paperdink/paperd.ink_hw/rev2/Output/DXF/paperd.ink.dxf

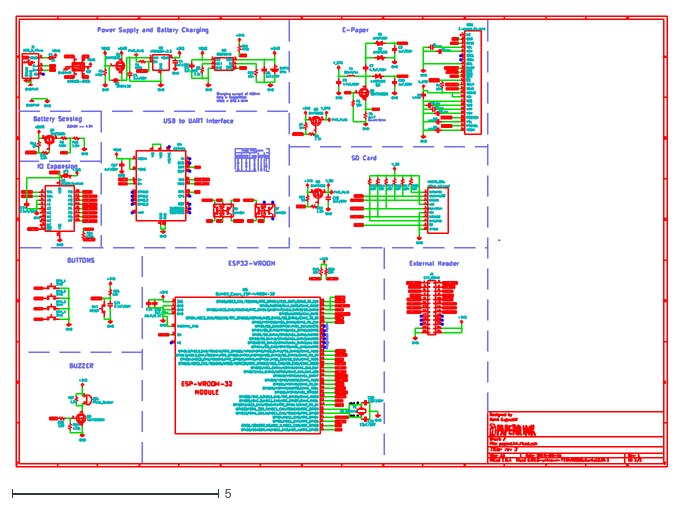
[picture p1: CAD file, 2022-04-13, an earlier design]
rev2/Output/DXF/paperd.ink.dxf
15.7 x 10.9
