paperdink/paperd.ink_hw/(list of files, cad)

Other CAD files:
rev1/Output/DXF/paperd.ink_main_pcb-B_SilkS.dxf
rev1/Output/DXF/paperd.ink_main_pcb-F_SilkS.dxf
