paperdink/paperd.ink_hw/rev4/Output/paperd_ink_rev4.pdf

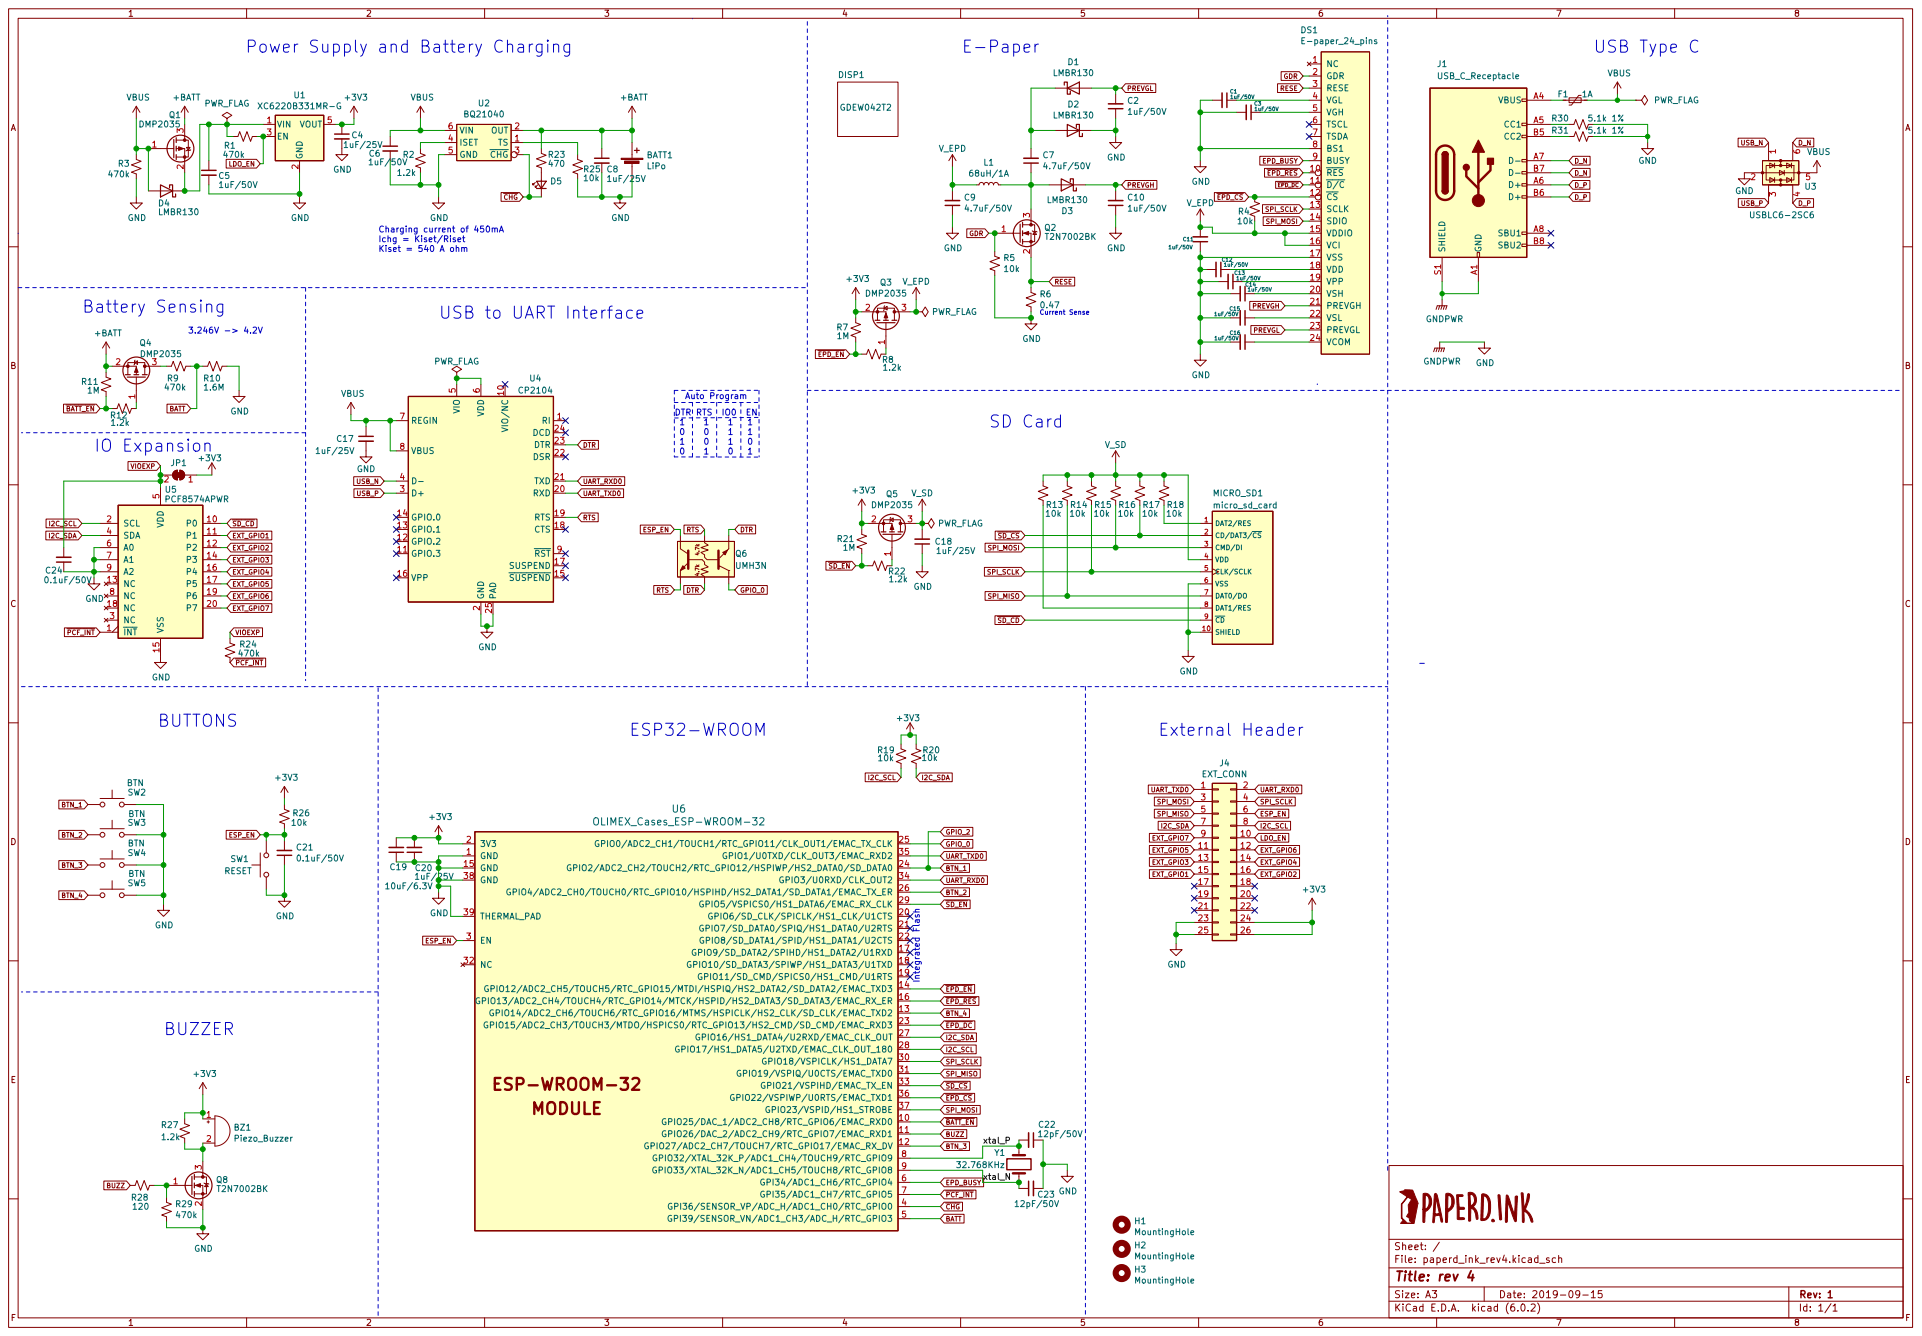
[picture p2: page 1]

Current Sense E-Paper Integrated Flash

- Power Supply and Battery Charging

0 1 0 1 Charging current of 450mA
Ichg = Kiset/Riset Kiset = 540 A ohm

USB to UART Interface

6 REGIN 7 VBUS 8 ~{RST} 9 U4 CP2104 GND

2 RXD 20 TXD 21 DSR 22 DTR 23 DCD 24 PAD 25 D+ 3 D- 4 VIO
