paperdink/paperd.ink_hw/rev1/Output/PDF/paperd.ink_V1.pdf

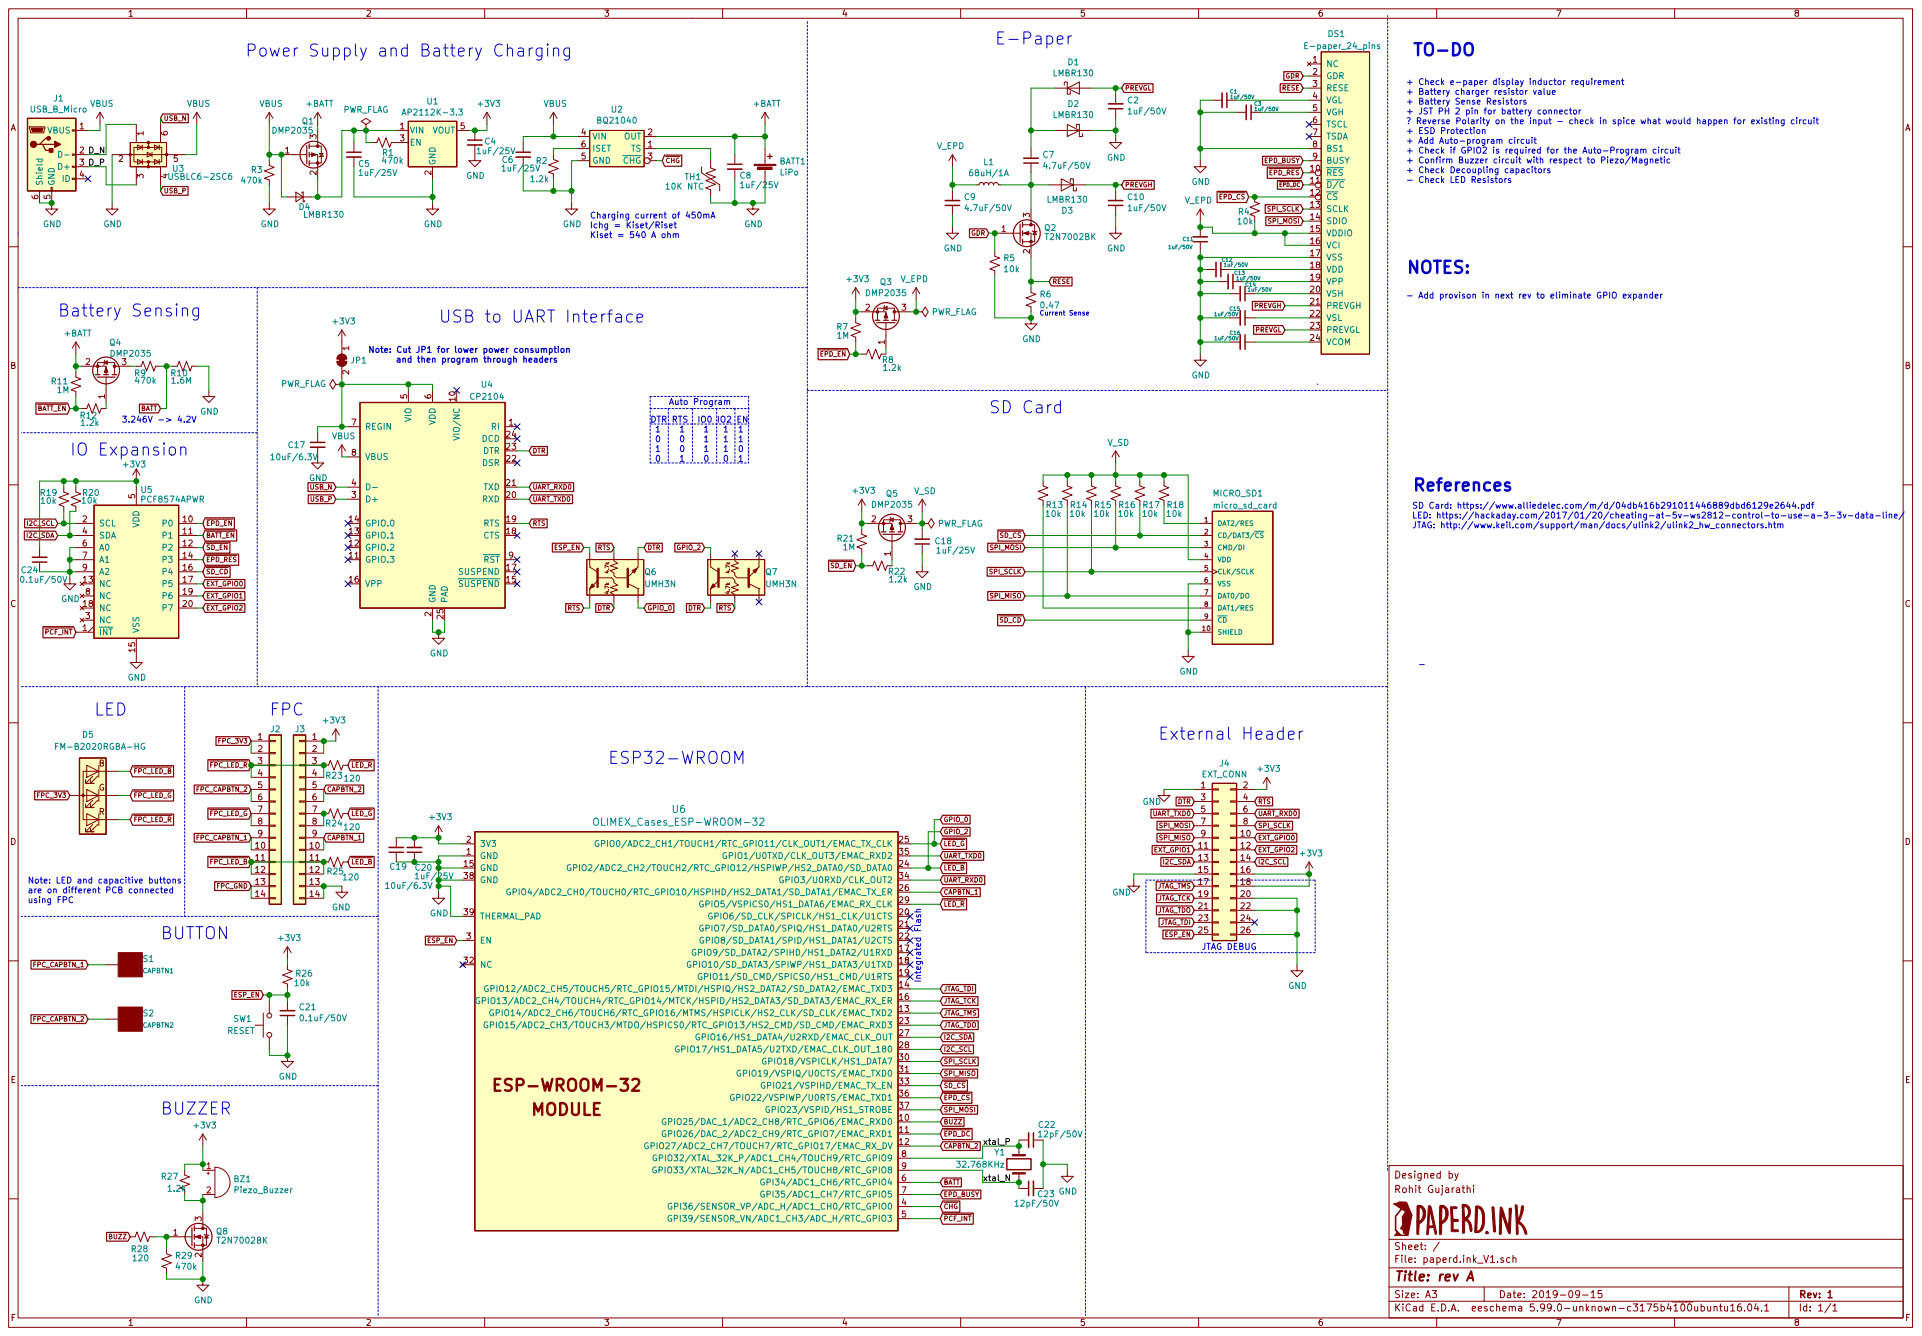
[picture p3: page 1]

2 3 Q2T2N7002BK Power Supply and Battery Charging TO-DO

+ Check e-paper display inductor requirement
+ Battery charger resistor value
+ Battery Sense Resistors
+ JST PH 2 pin for battery connector
? Reverse Polarity on the input - check in spice what would happen for existing circuit + ESD Protection + Add Auto-program circuit

VBUS GND Battery Sensing

2 EN 3 VOUT 5 U1 AP2112K-3.3 TS 1 OUT 2 CHG 3 VIN 4 GND 5

6 REGIN 7 VBUS 8 RST 9 U4 CP2104 VIN 1 GND

+ Check if GPIO2 is required for the Auto-Program circuit
+ Confirm Buzzer circuit with respect to Piezo/Magnetic
+ Check Decoupling capacitors

Ichg = Kiset/Riset Kiset = 540 A ohm

- Add provison in next rev to eliminate GPIO expander

Note: Cut JP1 for lower power consumption

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

SD Card: https://www.alliedelec.com/m/d/04db416b291011446889dbd6129e2644.pdf
LED: https://hackaday.com/2017/01/20/cheating-at-5v-ws2812-control-to-use-a-3-3v-data-line/
JTAG: http://www.keil.com/support/man/docs/ulink2/ulink2_hw_connectors.htm

BUZZ Note: LED and capacitive buttons are on different PCB connected using FPC

Designed by
File: paperd.ink_V1.sch Sheet: / Rohit Gujarathi
