paperdink/paperd.ink_hw/rev2/Output/PDF/paperd.ink.pdf

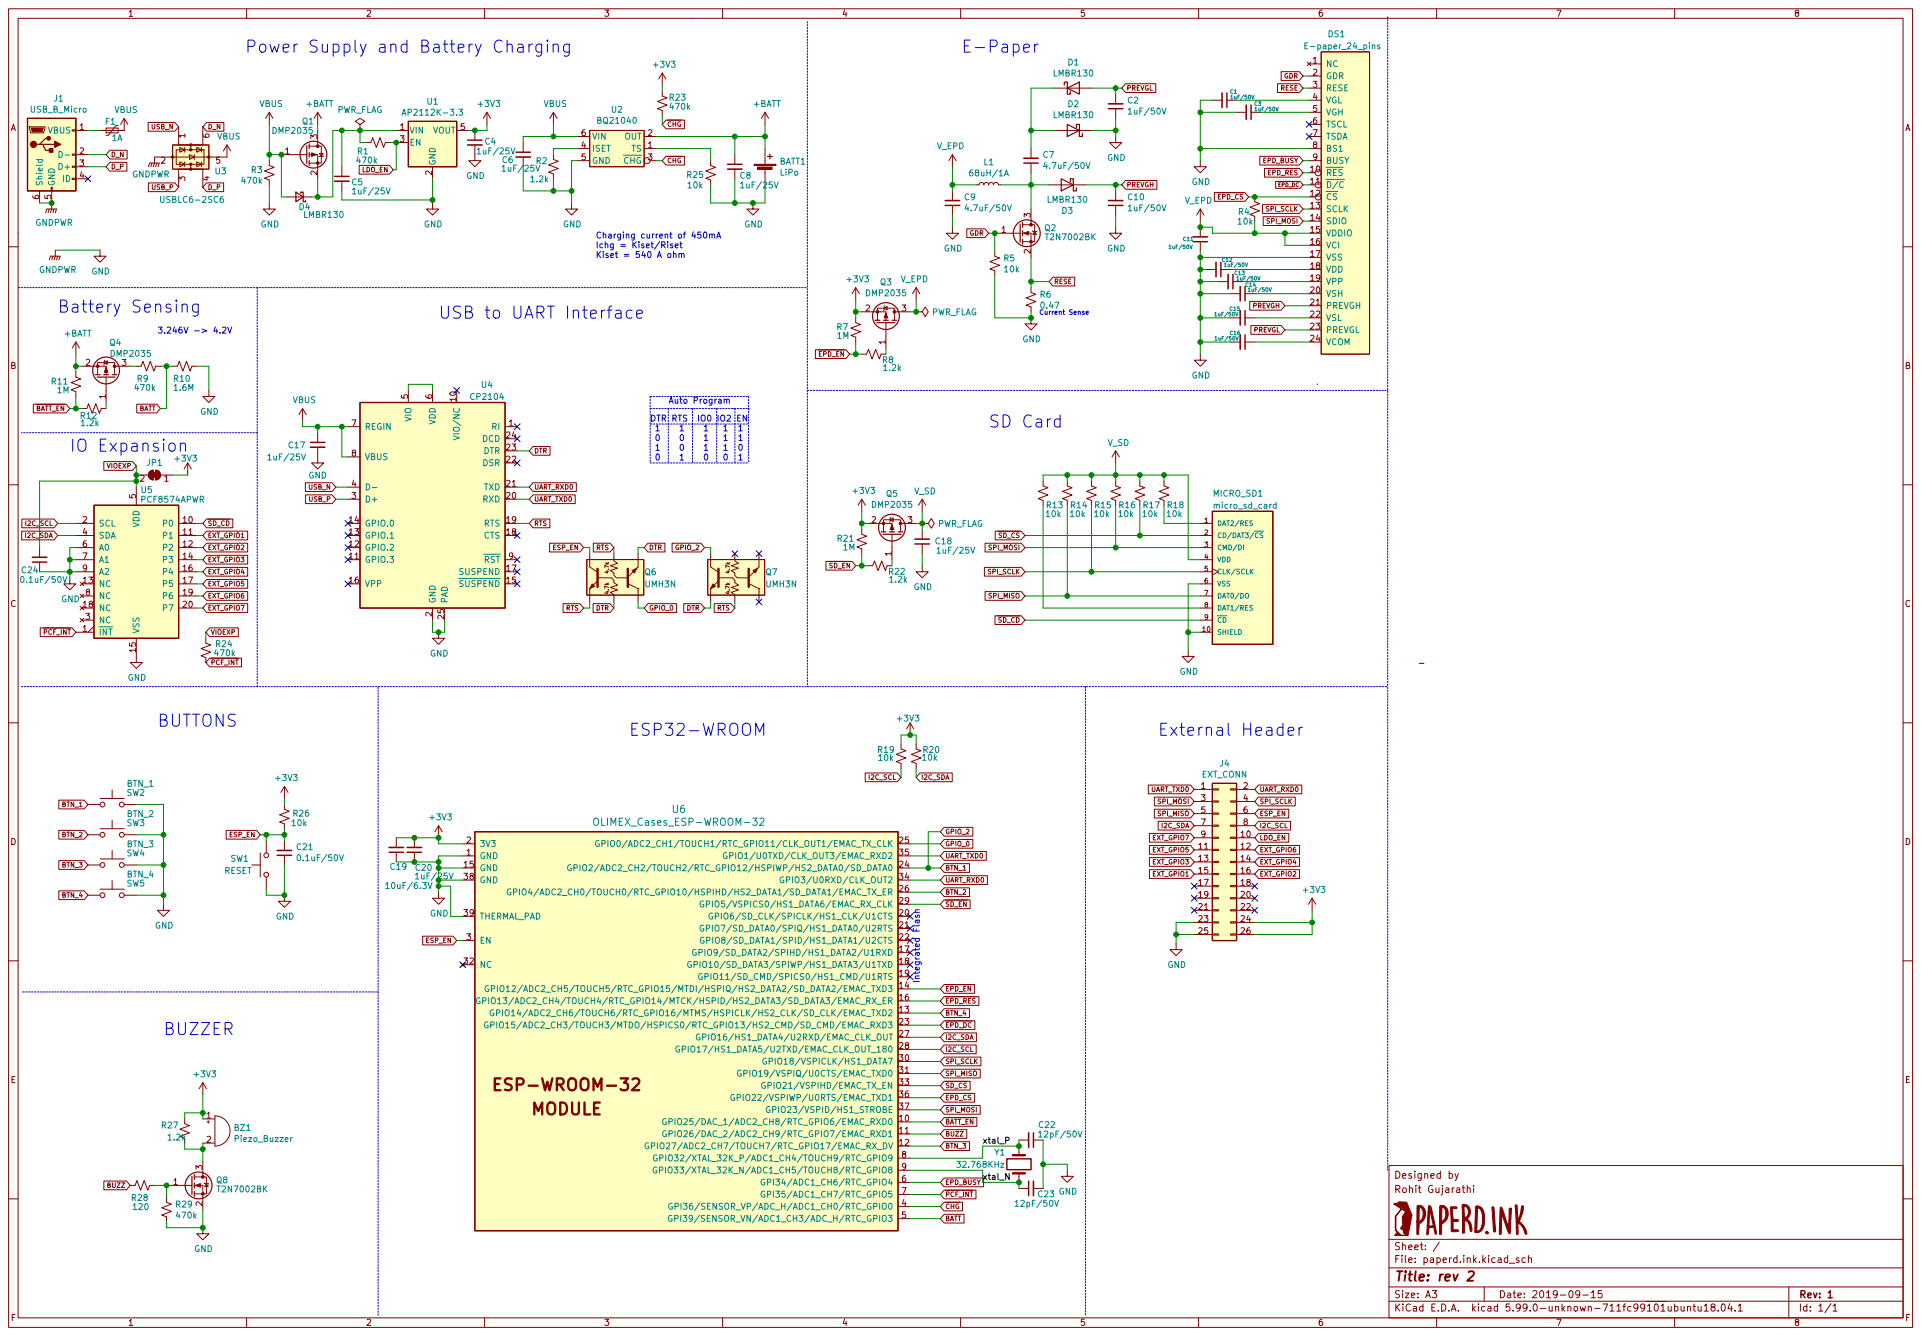
[picture p4: page 1]

Power Supply and Battery Charging

2 EN 3 VOUT 5 U1 AP2112K-3.3 +BATT VBUS R16
LMBR130 D4

Ichg = Kiset/Riset Kiset = 540 A ohm

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

Designed by
File: paperd.ink.kicad_sch Sheet: / Rohit Gujarathi
