paperdink/paperd.ink_hw/rev4/paperd_ink_rev4.kicad_pcb

## KiCad design rev4/paperd_ink_rev4.kicad_pcb (2022-07-19)

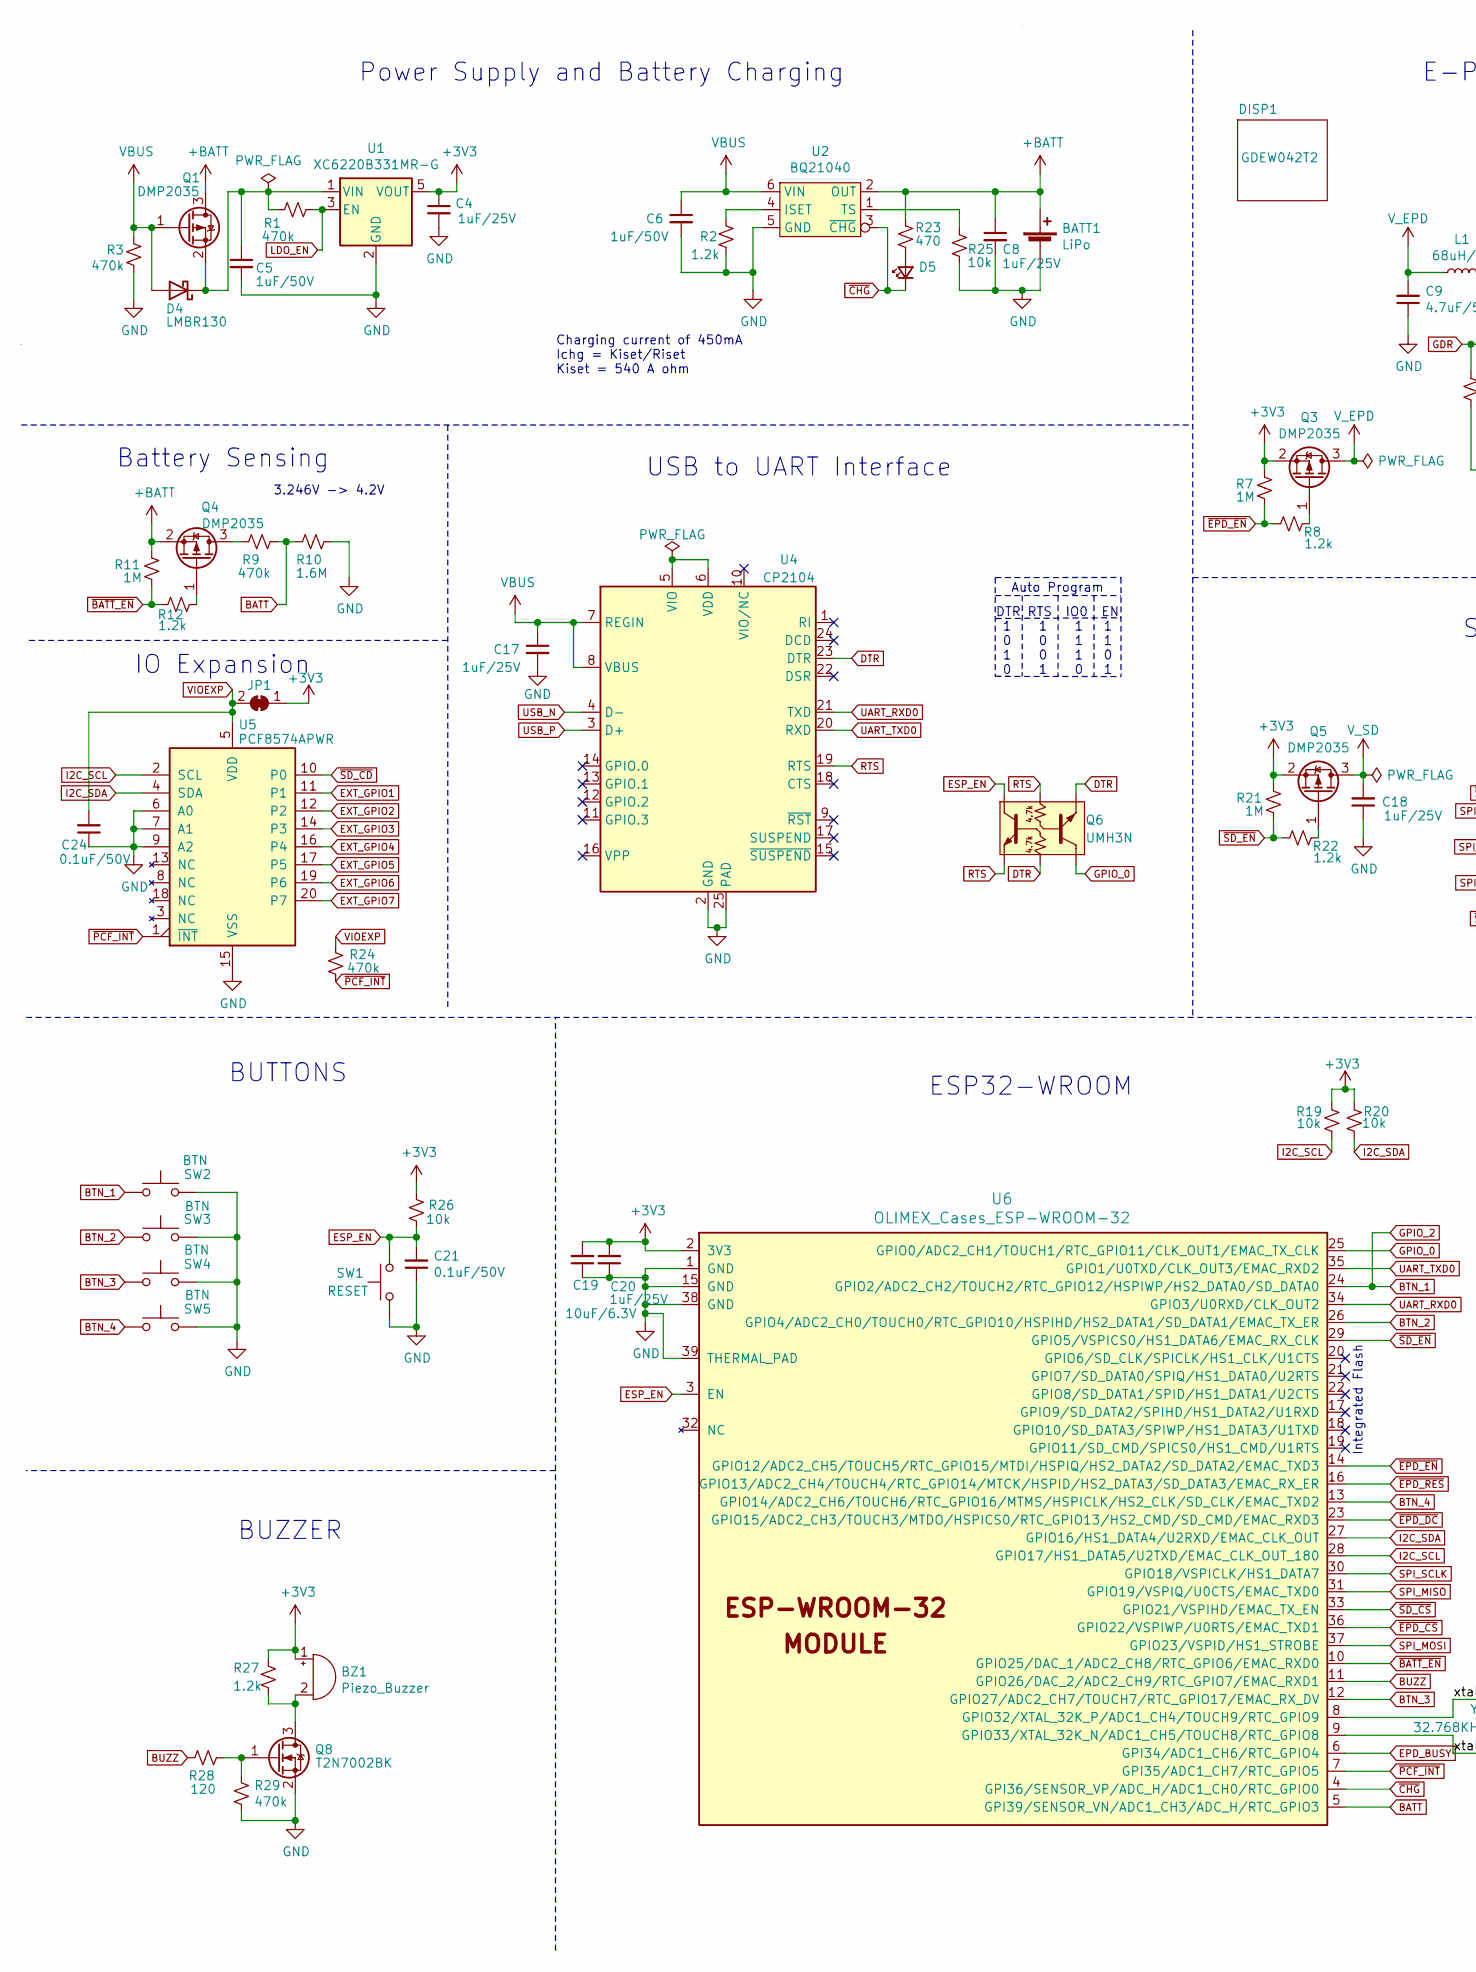
[picture p5: schematic paperd_ink_rev4.kicad_sch, rev 4, part in row 1, column 1]

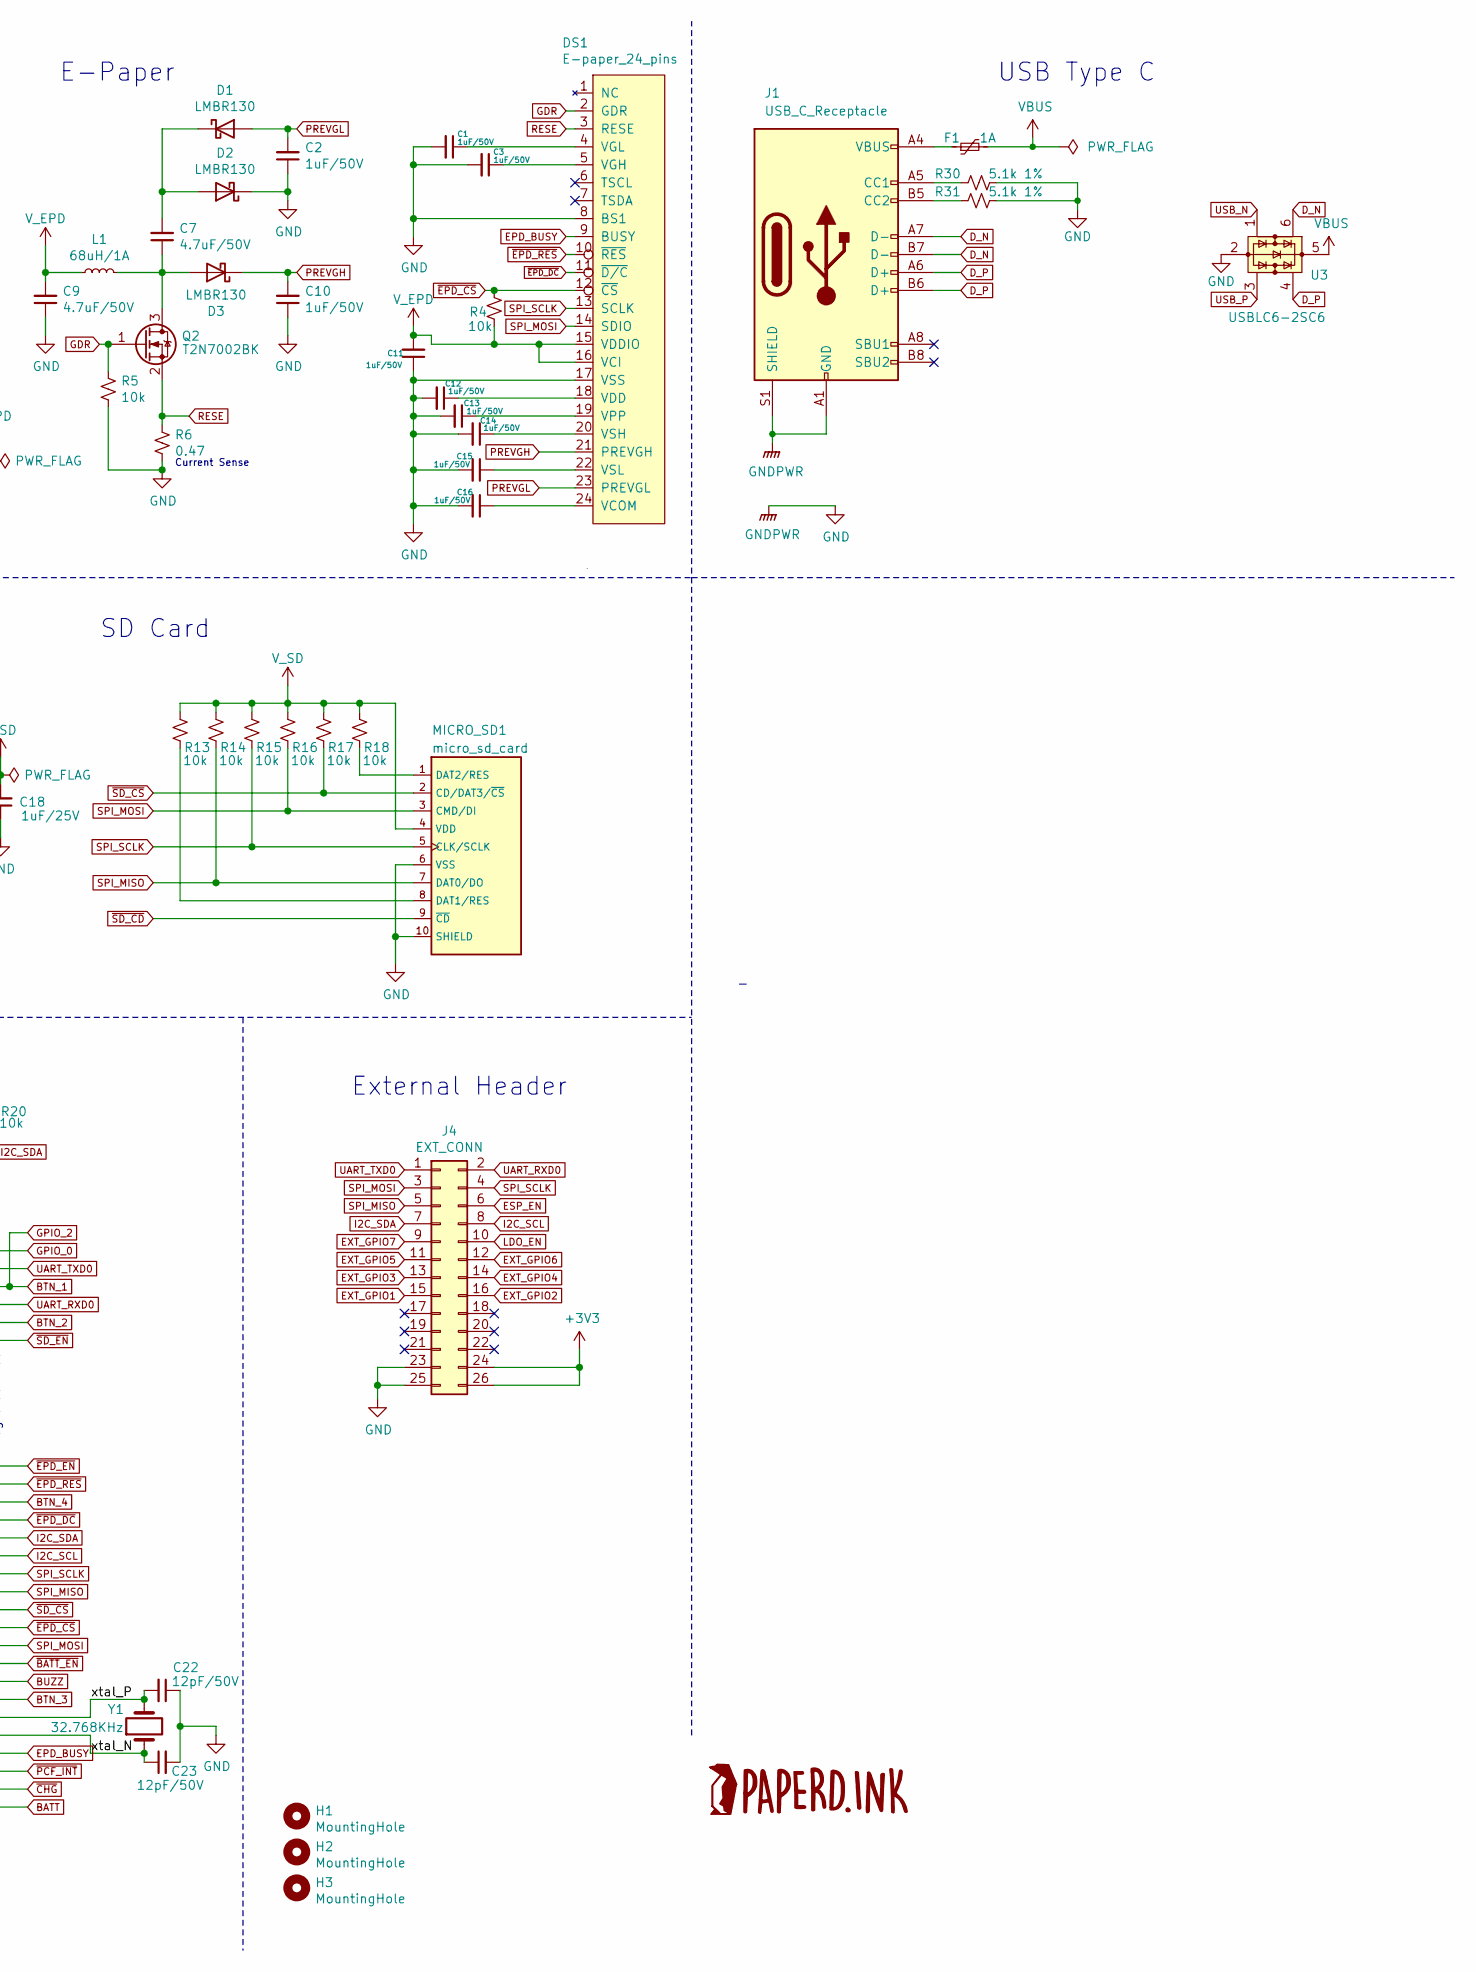
[picture p6: schematic paperd_ink_rev4.kicad_sch, rev 4, part in row 1, column 2]

Parts:
BATT1: LiPo; JST_PH_B2B-PH-SM4-TB_1x02-1MP_P2.00mm_Vertical; MPN C47647; LCSC C47647
BZ1: Piezo_Buzzer; KLJ-1230; MPN KLJ-1230; LCSC C201042
C1, C2, C3, C5, C6, C10, C11, C12, C13, C14, C15, C16: 1uF/50V; C_0603_1608Metric; MPN CL10A105KB8NNNC; LCSC C15849
C4, C8, C17, C18, C20: 1uF/25V; C_0402_1005Metric; MPN CL05A105KA5NQNC; LCSC C52923
C7, C9: 4.7uF/50V; C_0805_2012Metric; MPN CL21A475KBQNNNE; LCSC C98192
C19: 10uF/6.3V; C_0402_1005Metric; MPN CL05A106MQ5NUNC; LCSC C15525
C21, C24: 0.1uF/50V; C_0402_1005Metric; MPN CC0402KRX5R9BB104; LCSC C105882
C22, C23: 12pF/50V; C_0402_1005Metric; MPN 0402CG120J500NT; LCSC C1547
D1, D2, D3, D4: LMBR130; D_SOD-123; MPN LMBR130T1G; LCSC C48974
D5: LED_Small; TJ-S1706SW6TGLC2R-A5; MPN TJ-S1706SW6TGLC2R-A5; LCSC C273612
DISP1: GDEW042T2; MPN GDEW042T2
DS1: E-paper_24_pins; 24 pin FPC connector; MPN 0.5-24P XGXJ-H2.0 119; LCSC C2858298
F1: 1A; Fuse_0805_2012Metric; MPN MF-PSMF050X-2; LCSC C116170
H1, H2, H3: MountingHole; JLCPCB_Tooling_Hole
J1: USB_C_Receptacle; USB_C_Receptacle_HRO_TYPE-C-31-M-12; MPN 918-418K2023S40019; LCSC C709035
J4: EXT_CONN; PinHeader_2x13_P2.54mm_Vertical_SMD; MPN DNP
JP1: IO_EXP_JMP; SolderJumper-2_P1.3mm_Bridged_RoundedPad1.0x1.5mm; MPN DNP
L1: 68uH/1A; L_1210_3225Metric; MPN CBC3225T680MR; LCSC C223227
MICRO_SD1: micro_sd_card; HYC77-TF09-200; MPN HYC77-TF09-200; LCSC C341092
Q1, Q3, Q4, Q5: DMP2035; SOT-23; MPN DMP2035U-7; LCSC C110499
Q2, Q8: T2N7002BK; SOT-23; MPN T2N7002BK,LM; LCSC C146372
Q6: UMH3N; SOT-363_SC-70-6; MPN UMH3N; LCSC C62892
R1, R3, R9, R24, R29: 470k; R_0402_1005Metric; MPN WR04X4703FTL; LCSC C168230
R2, R8, R12, R22, R27: 1.2k; R_0402_1005Metric; MPN WR04X122JTL; LCSC C170376
R4, R5, R13, R14, R15, R16, R17, R18, R19, R20, R25, R26: 10k; R_0402_1005Metric; MPN RMS04JT103; LCSC C208959
R6: 0.47; R_0603_1608Metric; MPN 0603WAF470LT5E; LCSC C23411
R7, R11, R21: 1M; R_0402_1005Metric; MPN RMS04FT1004; LCSC C208777
R10: 1.6M; R_0402_1005Metric; MPN AC0402FR-071M6L; LCSC C226874
R23: 470; R_0402_1005Metric; MPN 0402WGJ0471TCE; LCSC C25167
R28: 120; R_0402_1005Metric; MPN WR04X1200FTL; LCSC C168196
R30, R31: 5.1k 1%; R_0402_1005Metric; MPN WR04X5101FTL; LCSC C163833
SW1: RESET; K2-1822SA-A3DW-06; MPN K2-1822SA-A3DW-06; LCSC C128937
SW2, SW3, SW4, SW5: BTN; TS36CA-0.7; MPN TS36CA-0.7; LCSC C412365
U1: XC6220B331MR-G; SOT-23-5; MPN XC6220B331MR-G; LCSC C86534
U2: BQ21040; SOT-23-6; MPN BQ21040DBVR; LCSC C202311
U3: USBLC6-2SC6; SOT-23-6; MPN USBLC6-2SC6; LCSC C558442
U4: CP2104; QFN-24-1EP_4x4mm_P0.5mm_EP2.6x2.6mm; MPN CP2104-F03-GMR; LCSC C47742
U5: PCF8574APWR; TSSOP-20_4.4x6.5mm_P0.65mm; MPN PCF8574TS/3,118; LCSC C57790
U6: OLIMEX_Cases_ESP-WROOM-32; ESP32-WROOM-32; MPN ESP32-WROOM-32D; LCSC C473012
Y1: 32.768KHz; Q13FC1350000400; MPN Q13FC1350000400; LCSC C32346

Connections:
+3V3: BZ1.1 (-), C4.1, C19.2, C20.2, J4.24, J4.26, JP1.1 (A), Q3.2 (S), Q5.2 (S), R7.2, R19.2, R20.2, R21.2, R26.1, R27.1, U1.5 (VOUT), U6.2 (3V3)
+BATT: BATT1.1 (+), C8.1, Q1.3 (D), Q4.2 (S), R11.2, R23.1, U2.2 (OUT)
/xtal_N: C23.1, U6.9 (GPIO33/XTAL_32K_N/ADC1_CH5/TOUCH8/RTC_G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), Y1.1
/xtal_P: C22.2, U6.8 (GPIO32/XTAL_32K_P/ADC1_CH4/TOUCH9/RTC_G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), Y1.2
BATT: R9.1, R10.2, U6.5 (GPI39/SENSOR_VN/ADC1_CH3/ADC_H/RTC_GPIO3)
BTN_1: SW2.2, U6.24 (GPIO2/ADC2_CH2/TOUCH2/RTC_GPIO12/HSPIWP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)
BTN_2: SW3.2, U6.26 (GPIO4/ADC2_CH0/TOUCH0/RTC_GPIO10/HSPIHD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)
BTN_3: SW4.2, U6.12 (GPIO27/ADC2_CH7/TOUCH7/RTC_GPIO17/EMAC_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)
BTN_4: SW5.2, U6.13 (GPIO14/ADC2_CH6/TOUCH6/RTC_GPIO16/MTMS/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)
BUZZ: R28.2, U6.11 (GPIO26/DAC_2/ADC2_CH9/RTC_GPIO7/EMAC_RX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)
DTR: Q6.2 (B1), Q6.4 (E2), U4.23 (DTR)
D_N: J1.A7 (D-), J1.B7 (D-), U3.6 (IO1)
D_P: J1.A6 (D+), J1.B6 (D+), U3.4 (IO2)
EPD_BUSY: DS1.9 (BUSY), U6.6 (GPI34/ADC1_CH6/RTC_GPIO4)
ESP_EN: C21.2, J4.6, Q6.6 (C1), R26.2, SW1.2, U6.3 (EN)
EXT_GPIO1: J4.15, U5.11 (P1)
EXT_GPIO2: J4.16, U5.12 (P2)
EXT_GPIO3: J4.13, U5.14 (P3)
EXT_GPIO4: J4.14, U5.16 (P4)
EXT_GPIO5: J4.11, U5.17 (P5)
EXT_GPIO6: J4.12, U5.19 (P6)
EXT_GPIO7: J4.9, U5.20 (P7)
GDR: DS1.2 (GDR), Q2.1 (G), R5.1
GND: BATT1.2 (-), C1.2, C2.1, C3.2, C4.2, C5.2, C6.2, C8.2, C9.1, C10.1, C11.1, C12.2, C13.2, C14.2, C15.2, C16.2, C17.2, C18.1, C19.1, C20.1, C21.1, C22.1, C23.2, C24.1, D2.1 (K), DS1.8 (BS1), DS1.17 (VSS), J1.A1 (GND), J1.A12 (GND), J1.B1 (GND), J1.B12 (GND), J1.S1 (SHIELD), J4.23, J4.25, MICRO_SD1.6 (VSS), MICRO_SD1.10 (SHIELD), Q8.2 (S), R2.2, R3.2, R5.2, R6.2, R10.1, R25.2, R29.2, R30.1, R31.1, SW1.1, SW2.1, SW3.1, SW4.1, SW5.1, U1.2 (GND), U2.5 (GND), U3.2 (GND), U4.2 (GND), U4.25 (PAD), U5.6 (A0), U5.7 (A1), U5.9 (A2), U5.15 (VSS), U6.1 (GND), U6.15 (GND), U6.38 (GND), U6.39 (THERMAL_PAD)
GPIO_0: Q6.3 (C2), U6.25 (GPIO0/ADC2_CH1/TOUCH1/RTC_GPIO11/CLK_OU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)
I2C_SCL: J4.8, R19.1, U5.2 (SCL), U6.28 (GPIO17/HS1_DATA5/U2TXD/EMAC_CLK_OUT_180)
I2C_SDA: J4.7, R20.1, U5.4 (SDA), U6.27 (GPIO16/HS1_DATA4/U2RXD/EMAC_CLK_OUT)
LDO_EN: J4.10, R1.2, U1.3 (EN)
unnamed: BZ1.2 (+), Q8.3 (D), R27.2
unnamed: C1.1, DS1.4 (VGL)
unnamed: C3.1, DS1.5 (VGH)
unnamed: C5.1, D4.1 (K), Q1.2 (S), R1.1, U1.1 (VIN)
unnamed: C7.1, D3.2 (A), L1.2, Q2.3 (D)
unnamed: C7.2, D1.1 (K), D2.2 (A)
unnamed: C12.1, DS1.18 (VDD)
unnamed: C13.1, DS1.19 (VPP)
unnamed: C14.1, DS1.20 (VSH)
unnamed: C15.1, DS1.22 (VSL)
unnamed: C16.1, DS1.24 (VCOM)
unnamed: D5.2 (A), R23.2
unnamed: F1.1, J1.A4 (VBUS), J1.A9 (VBUS), J1.B4 (VBUS), J1.B9 (VBUS)
unnamed: J1.A5 (CC1), R30.2
unnamed: J1.B5 (CC2), R31.2
unnamed: MICRO_SD1.1 (DAT2/RES), R18.2
unnamed: MICRO_SD1.8 (DAT1/RES), R13.2
unnamed: Q3.1 (G), R8.1
unnamed: Q4.1 (G), R12.1
unnamed: Q4.3 (D), R9.2
unnamed: Q5.1 (G), R22.1
unnamed: Q8.1 (G), R28.1, R29.1
unnamed: R2.1, U2.4 (ISET)
unnamed: R25.1, U2.1 (TS)
unnamed: U4.5 (VIO), U4.6 (VDD)
PREVGH: C10.2, D3.1 (K), DS1.21 (PREVGH)
PREVGL: C2.2, D1.2 (A), DS1.23 (PREVGL)
RESE: DS1.3 (RESE), Q2.2 (S), R6.1
RTS: Q6.1 (E1), Q6.5 (B2), U4.19 (RTS)
SPI_MISO: J4.5, MICRO_SD1.7 (DAT0/DO), R14.2, U6.31 (GPIO19/VSPIQ/U0CTS/EMAC_TXD0)
SPI_MOSI: DS1.14 (SDIO), J4.3, MICRO_SD1.3 (CMD/DI), R16.2, U6.37 (GPIO23/VSPID/HS1_STROBE)
SPI_SCLK: DS1.13 (SCLK), J4.4, MICRO_SD1.5 (CLK/SCLK), R15.2, U6.30 (GPIO18/VSPICLK/HS1_DATA7)
UART_RXD0: J4.2, U4.21 (TXD), U6.34 (GPIO3/U0RXD/CLK_OUT2)
UART_TXD0: J4.1, U4.20 (RXD), U6.35 (GPIO1/U0TXD/CLK_OUT3/EMAC_RXD2)
USB_N: U3.1 (IO1), U4.4 (D-)
USB_P: U3.3 (IO2), U4.3 (D+)
VBUS: C6.1, C17.1, D4.2 (A), F1.2, Q1.1 (G), R3.1, U2.6 (VIN), U3.5 (VBUS), U4.7 (REGIN), U4.8 (VBUS)
VIOEXP: C24.2, JP1.2 (B), R24.2, U5.5 (VDD)
V_EPD: C9.2, C11.2, DS1.15 (VDDIO), DS1.16 (VCI), L1.1, Q3.3 (D), R4.2
V_SD: C18.2, MICRO_SD1.4 (VDD), Q5.3 (D), R13.1, R14.1, R15.1, R16.1, R17.1, R18.1
~BATT_EN: R11.1, R12.2, U6.10 (GPIO25/DAC_1/ADC2_CH8/RTC_GPIO6/EMAC_RX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)
~CHG: D5.1 (K), U2.3 (~CHG), U6.4 (GPI36/SENSOR_VP/ADC_H/ADC1_CH0/RTC_GPIO0)
~EPD_CS: DS1.12 (~CS), R4.1, U6.36 (GPIO22/VSPIWP/U0RTS/EMAC_TXD1)
~EPD_DC: DS1.11 (~D/C), U6.23 (GPIO15/ADC2_CH3/TOUCH3/MTDO/HSPICS0/RTC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)
~EPD_EN: R7.1, R8.2, U6.14 (GPIO12/ADC2_CH5/TOUCH5/RTC_GPIO15/MTDI/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)
~EPD_RES: DS1.10 (~RES), U6.16 (GPIO13/ADC2_CH4/TOUCH4/RTC_GPIO14/MTCK/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)
~PCF_INT: R24.1, U5.1 (~INT), U6.7 (GPI35/ADC1_CH7/RTC_GPIO5)
~SD_CD: MICRO_SD1.9 (~CD), U5.10 (P0)
~SD_CS: MICRO_SD1.2 (CD/DAT3/~CS), R17.2, U6.33 (GPIO21/VSPIHD/EMAC_TX_EN)
~SD_EN: R21.1, R22.2, U6.29 (GPIO5/VSPICS0/HS1_DATA6/EMAC_RX_CLK)

Notes on the sheet:
DTR RTS IO0 EN 1 1 1 1 0 0 1 1 1 0 1 0 0 1 0 1
Charging current of 450mA Ichg = Kiset/Riset Kiset = 540 A ohm
Auto Program
3.246V -> 4.2V
External Header
Battery Sensing
Integrated Flash
E-Paper
BUTTONS
USB Type C
SD Card
Power Supply and Battery Charging
Current Sense
USB to UART Interface
IO Expansion
ESP32-WROOM
BUZZER

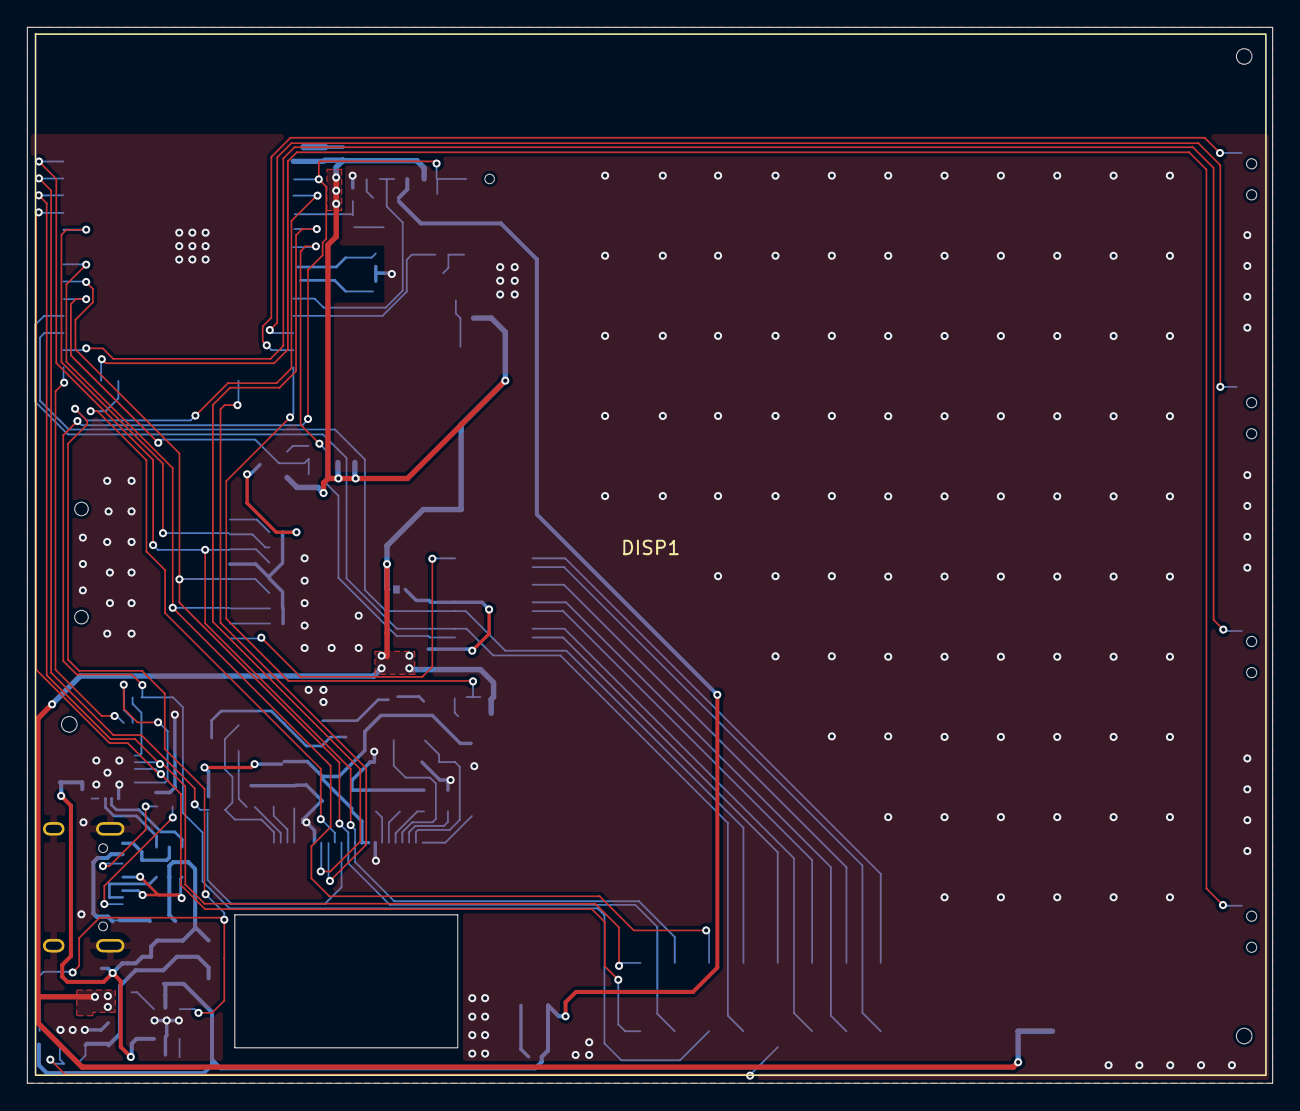
[picture p7: board paperd_ink_rev4.kicad_pcb from above]

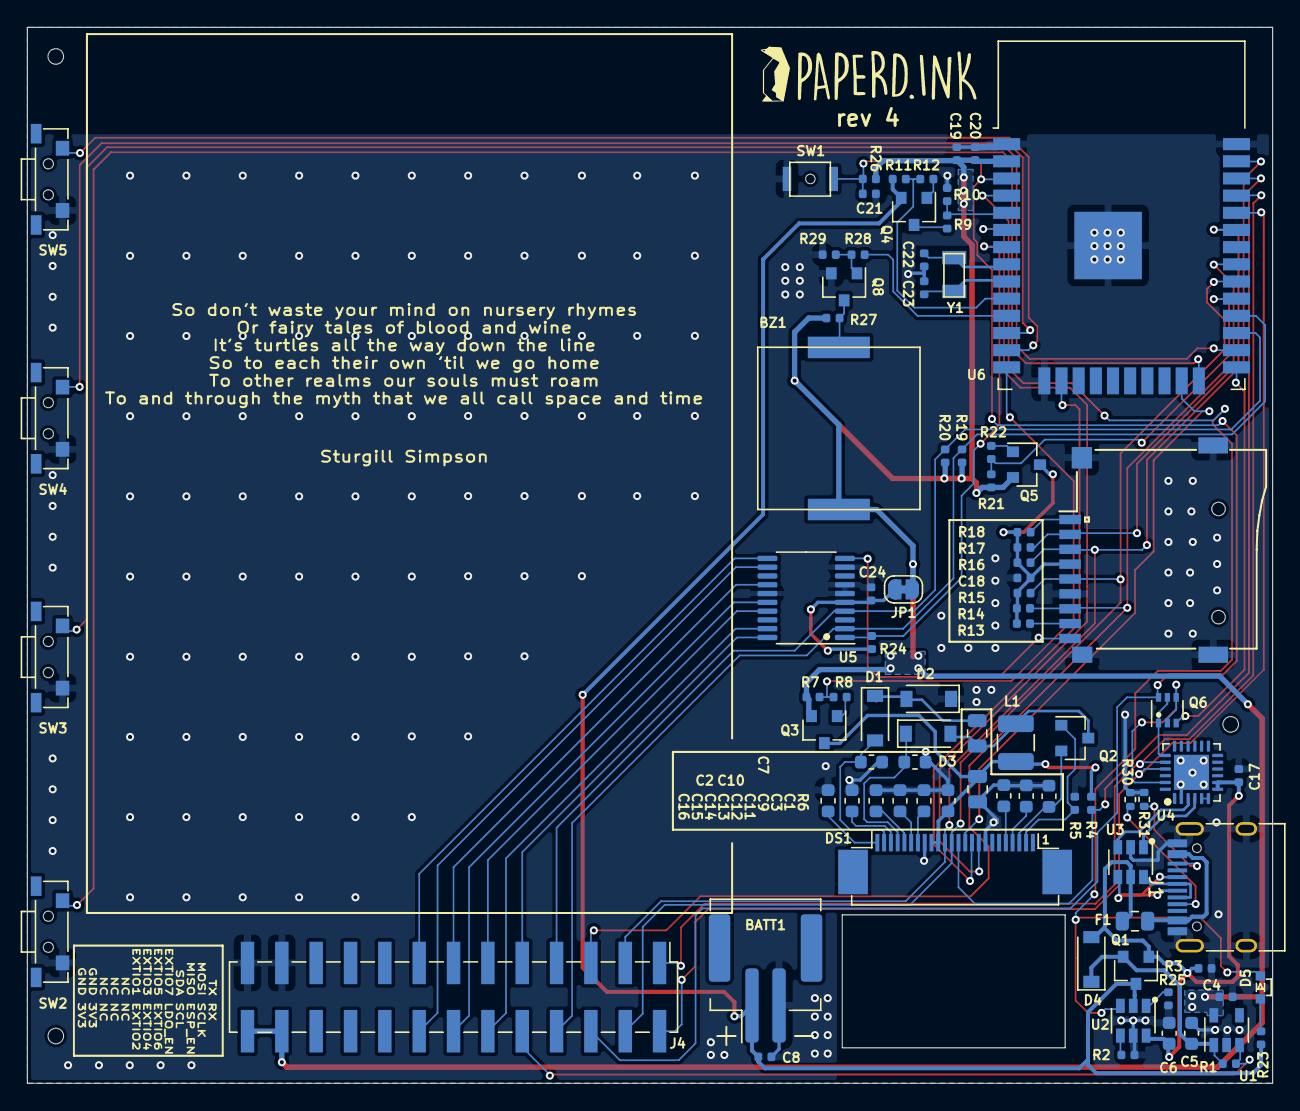
[picture p8: board paperd_ink_rev4.kicad_pcb from below]

Board: 2 copper layers, 92.1 x 78.1 mm, 92 parts (91 on the bottom side), 78 nets.
