paperdink/paperd.ink_hw/rev1/paperd.ink_main_pcb.kicad_pcb

## KiCad design rev1/paperd.ink_main_pcb.kicad_pcb (2022-04-13, an earlier design)

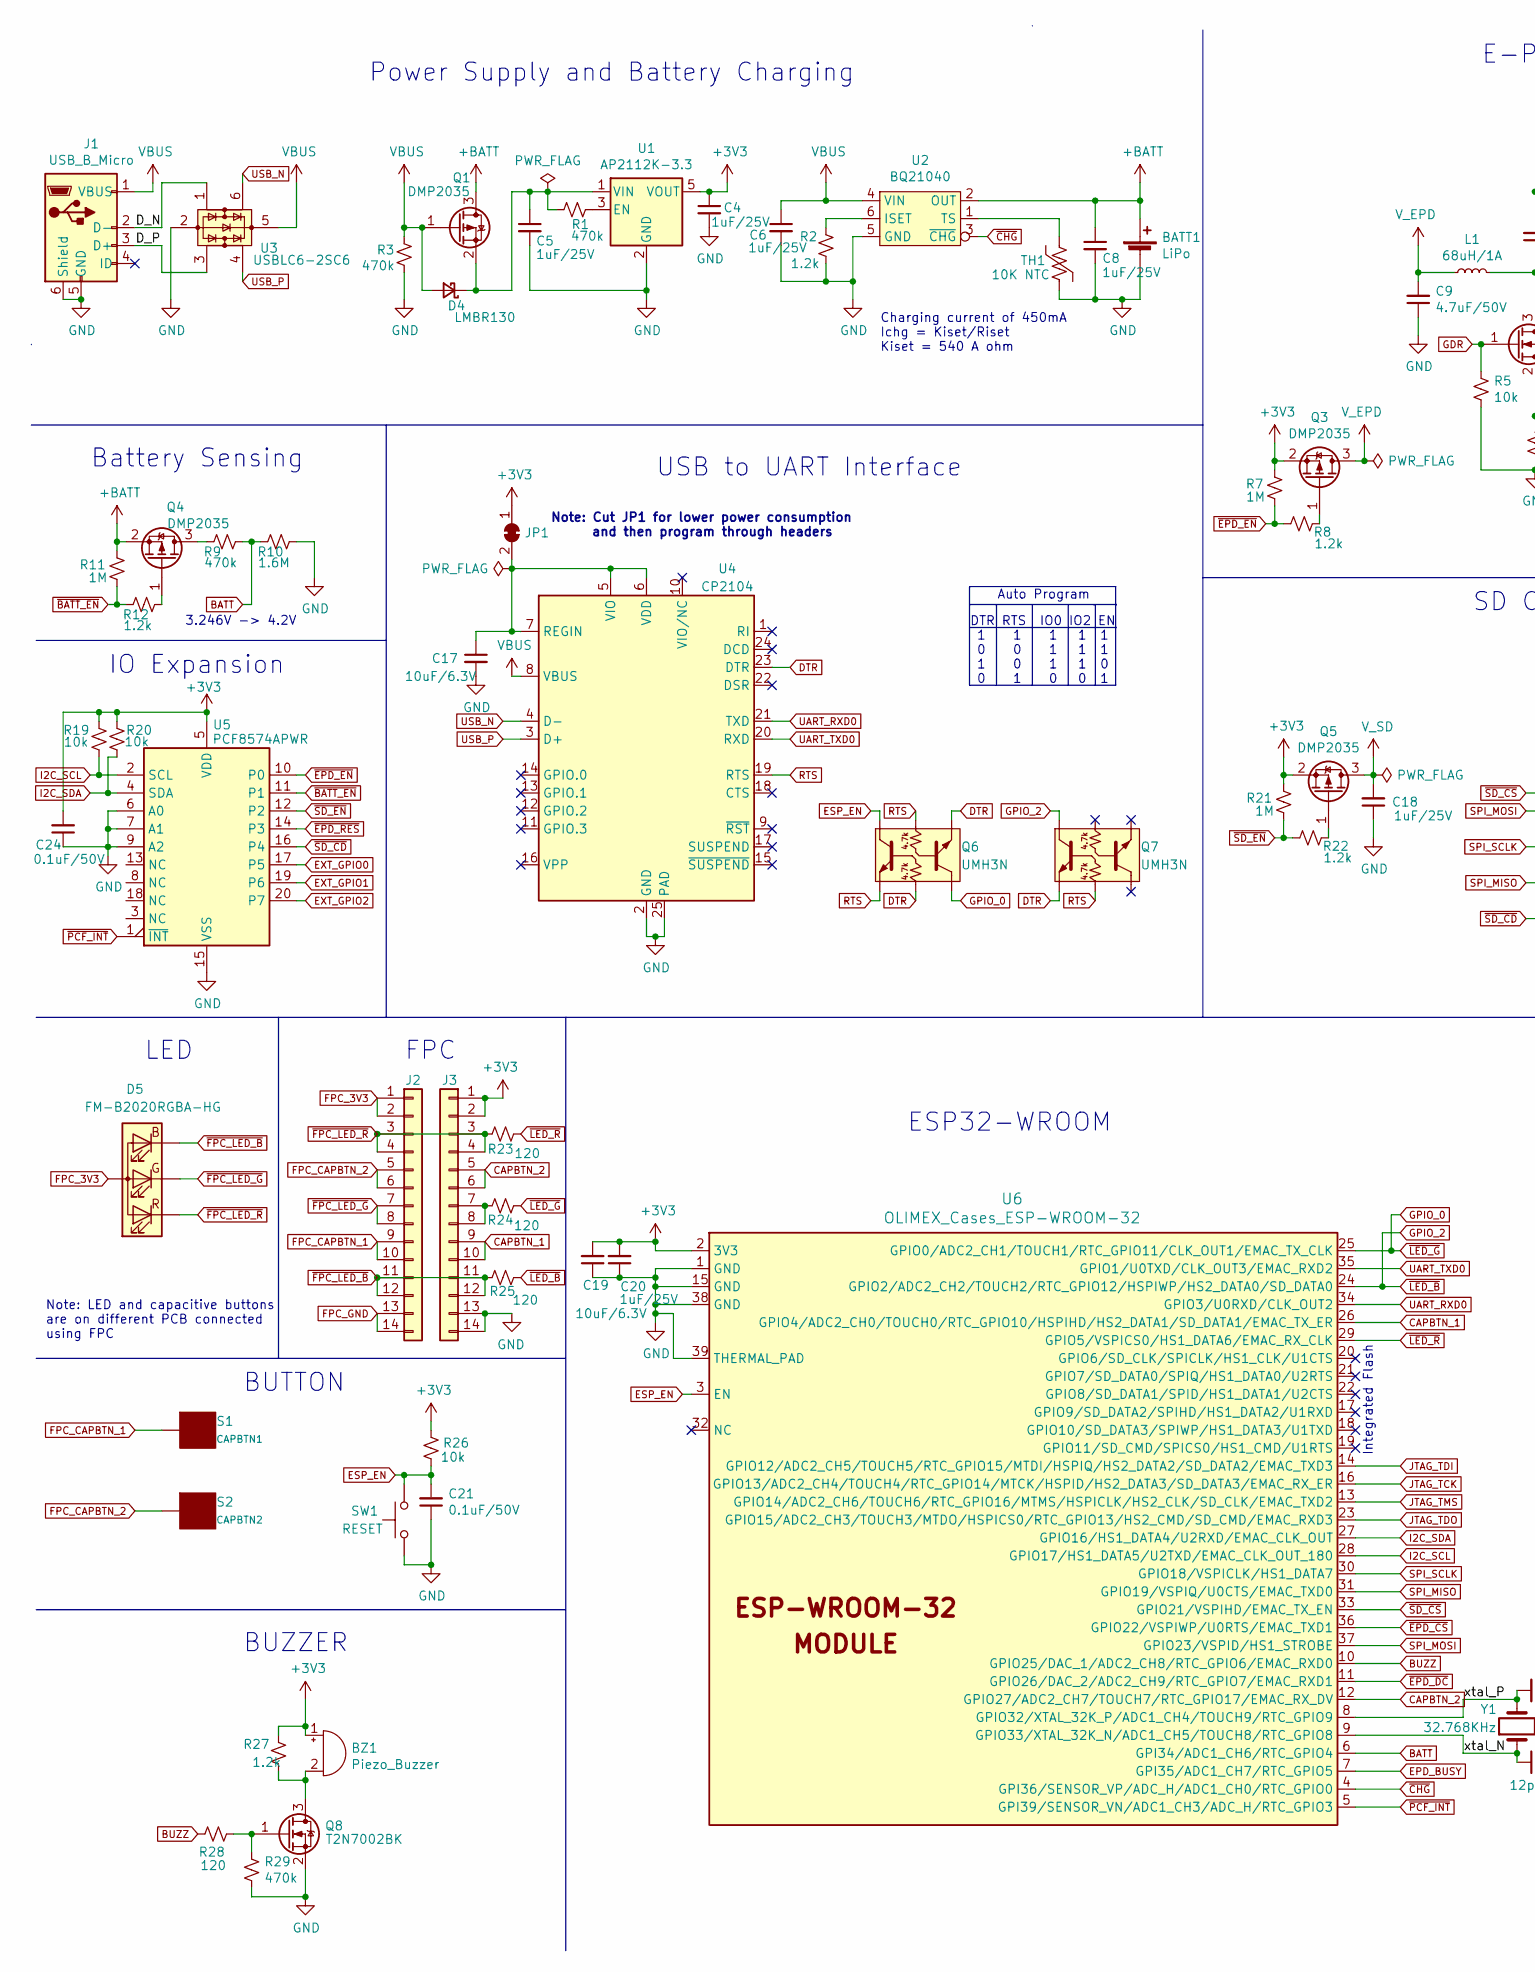
[picture p10: schematic paperd.ink_V1.kicad_sch, rev A, part in row 1, column 1]

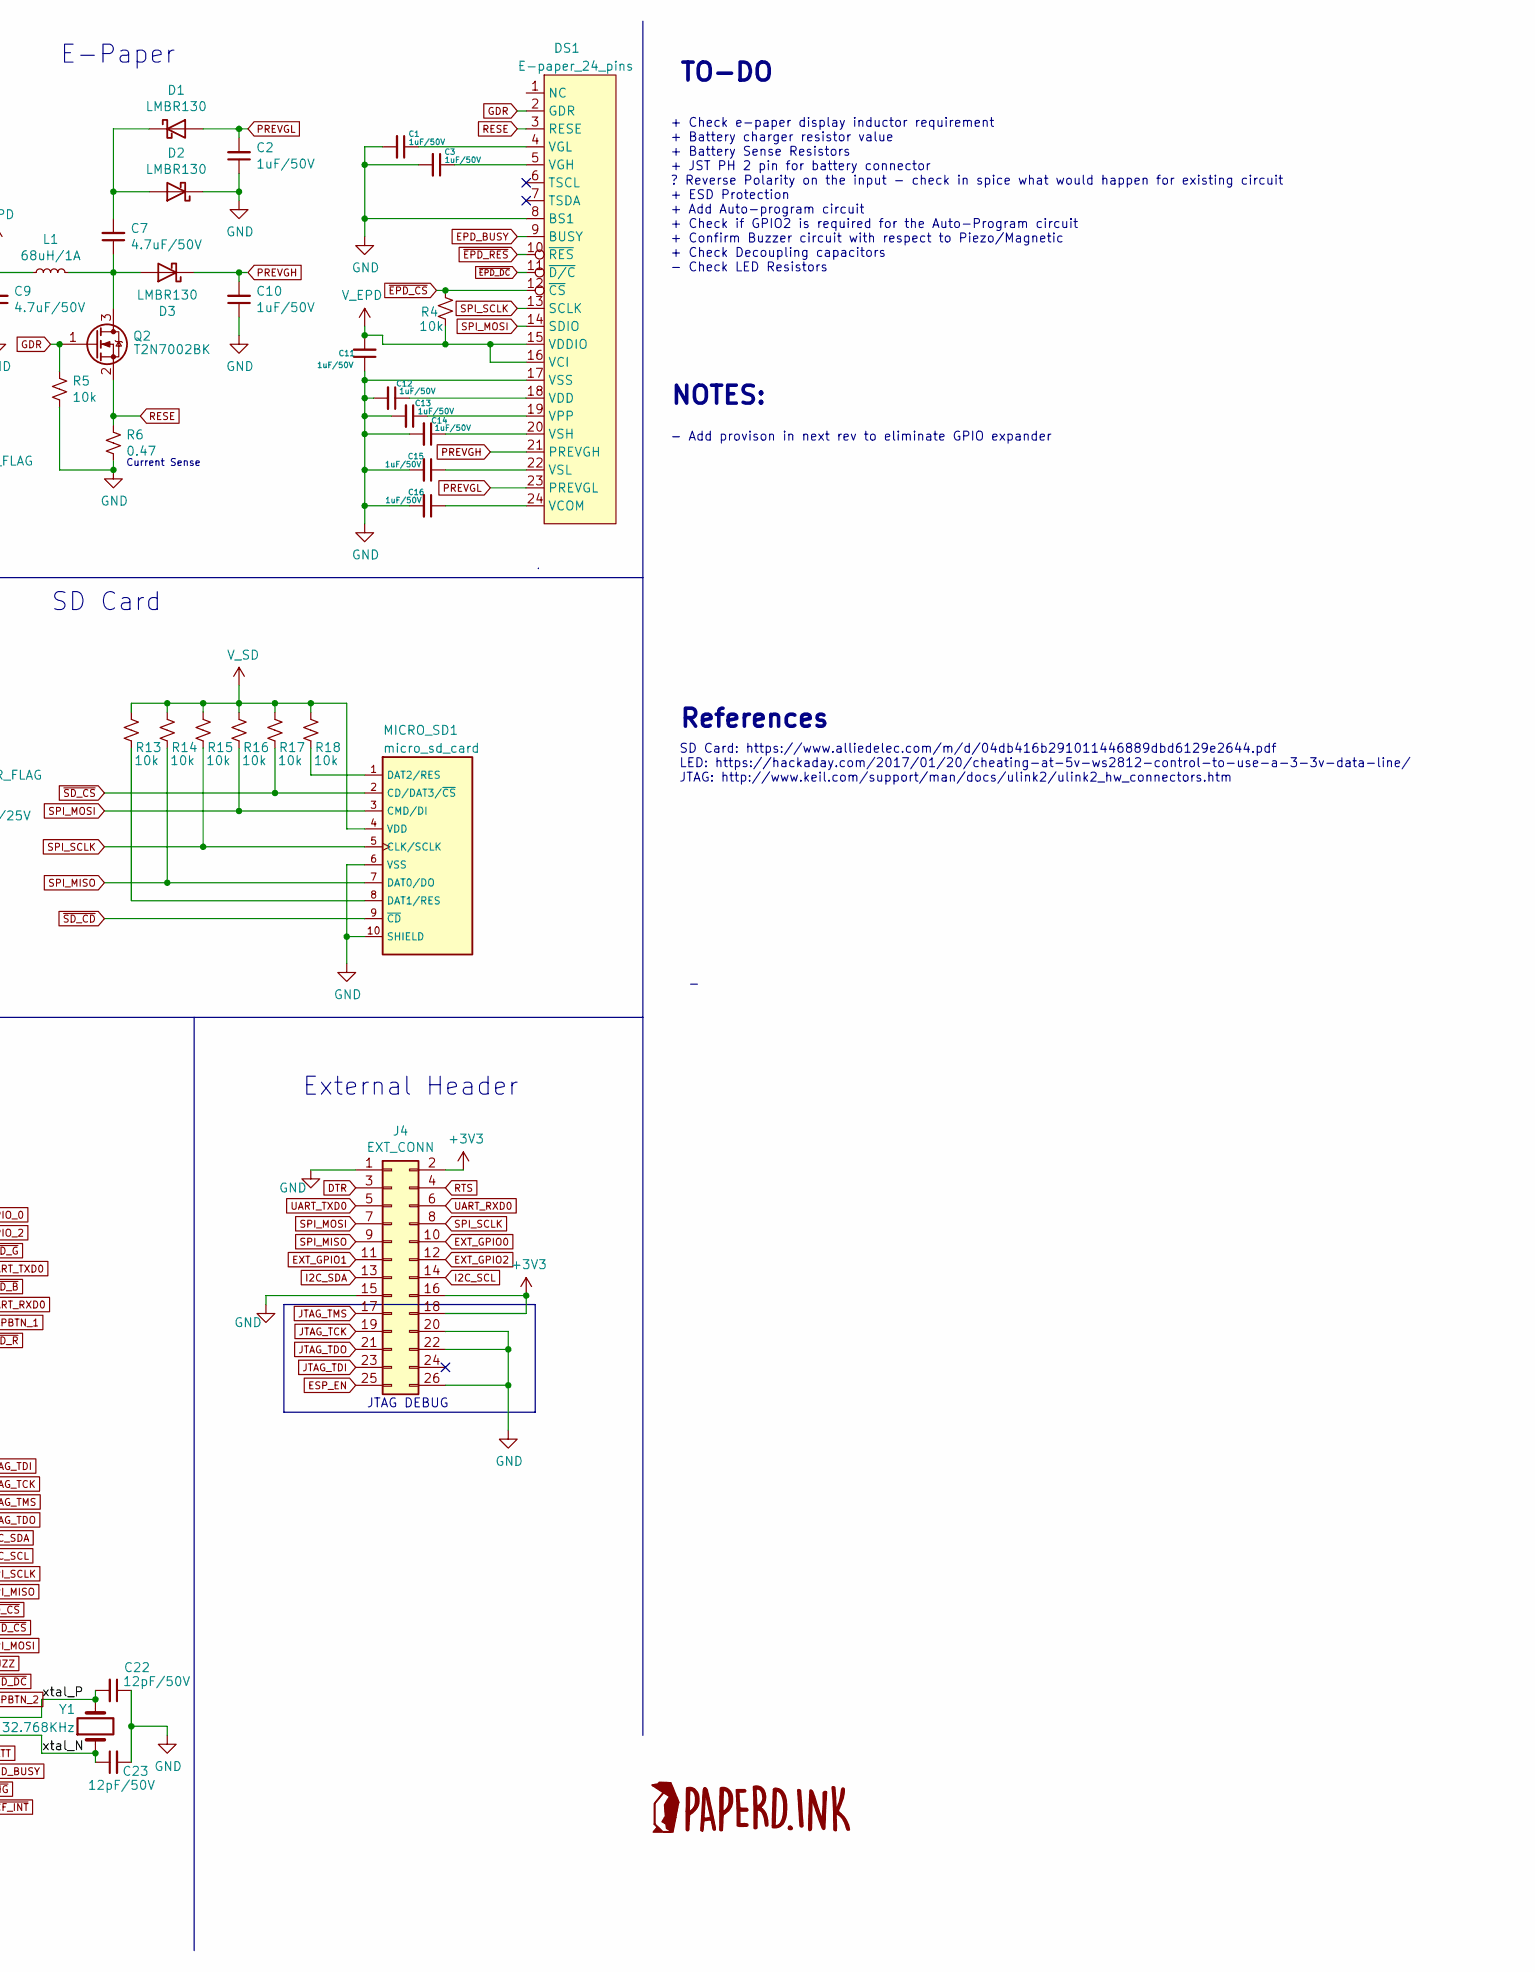
[picture p11: schematic paperd.ink_V1.kicad_sch, rev A, part in row 1, column 2]

Parts:
BATT1: LiPo; JST_PH_B2B-PH-SM4-TB_1x02-1MP_P2.00mm_Vertical
BZ1: Piezo_Buzzer; KLJ-1230
C1, C2, C3, C10, C11, C12, C13, C14, C15, C16: 1uF/50V; C_0603_1608Metric
C4, C5, C6, C8, C18, C20: 1uF/25V; C_0402_1005Metric
C7, C9: 4.7uF/50V; C_0805_2012Metric
C17, C19: 10uF/6.3V; C_0402_1005Metric
C21, C24: 0.1uF/50V; C_0402_1005Metric
C22, C23: 12pF/50V; C_0402_1005Metric
D1, D2, D3: LMBR130; D_SOD-123
D4: LMBR130; D_SOD-123F
D5: FM-B2020RGBA-HG
DS1: E-paper_24_pins; 4.2_inch_e_paper_bottom_layer
J1: USB_B_Micro; C77238
J2, J3: Conn_01x14; FPC_14P_0.5mm
J4: EXT_CONN; PinHeader_2x13_P2.54mm_Vertical_SMD
JP1: SolderJumper_2_Bridged; SolderJumper-2_P1.3mm_Bridged_RoundedPad1.0x1.5mm
L1: 68uH/1A; L_1210_3225Metric
MICRO_SD1: micro_sd_card; micro_SD_card
Q1, Q3, Q4, Q5: DMP2035; SOT-23
Q2, Q8: T2N7002BK; SOT-23
Q6, Q7: UMH3N; SOT-363_SC-70-6
R1, R3, R9, R29: 470k; R_0402_1005Metric
R2, R8, R12, R22, R27: 1.2k; R_0402_1005Metric
R4, R5, R13, R14, R15, R16, R17, R18, R19, R20, R26: 10k; R_0402_1005Metric
R6: 0.47; R_0603_1608Metric
R7, R11, R21: 1M; R_0402_1005Metric
R10: 1.6M; R_0402_1005Metric
R23, R24, R25, R28: 120; R_0402_1005Metric
S1: CAPBTN1; cap_touch_35x6
S2: CAPBTN2; cap_touch_35x6
SW1: RESET; K2-1822SA-A3DW-06
TH1: 10K NTC; R_0402_1005Metric
U1: AP2112K-3.3; SOT-23-5
U2: BQ21040; SOT-23-6
U3: USBLC6-2SC6; SOT-23-6
U4: CP2104; QFN-24-1EP_4x4mm_P0.5mm_EP2.6x2.6mm
U5: PCF8574APWR; TSSOP-20_4.4x6.5mm_P0.65mm
U6: OLIMEX_Cases_ESP-WROOM-32; ESP32-WROOM-32
Y1: 32.768KHz; Q13FC1350000400

Connections:
+3V3: BZ1.1 (-), C4.1, C19.2, C20.2, C24.2, J3.1, J3.2, J4.2, J4.16, J4.18, JP1.1 (A), Q3.2 (S), Q5.2 (S), R7.2, R19.2, R20.2, R21.2, R26.1, R27.1, U1.5 (VOUT), U5.5 (VDD), U6.2 (3V3)
+BATT: BATT1.1 (+), C8.1, Q1.3 (D), Q4.2 (S), R11.2, U2.2 (OUT)
/D_N: J1.2 (D-), U3.1 (IO1)
/D_P: J1.3 (D+), U3.3 (IO2)
/xtal_N: C23.1, U6.9 (GPIO33/XTAL_32K_N/ADC1_CH5/TOUCH8/RTC_G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), Y1.1
/xtal_P: C22.2, U6.8 (GPIO32/XTAL_32K_P/ADC1_CH4/TOUCH9/RTC_G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), Y1.2
BATT: R9.1, R10.2, U6.6 (GPI34/ADC1_CH6/RTC_GPIO4)
BUZZ: R28.2, U6.10 (GPIO25/DAC_1/ADC2_CH8/RTC_GPIO6/EMAC_RX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)
CAPBTN_1: J3.9, J3.10, U6.26 (GPIO4/ADC2_CH0/TOUCH0/RTC_GPIO10/HSPIHD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)
CAPBTN_2: J3.5, J3.6, U6.12 (GPIO27/ADC2_CH7/TOUCH7/RTC_GPIO17/EMAC_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)
DTR: J4.3, Q6.2 (B1), Q6.4 (E2), Q7.1 (E1), U4.23 (DTR)
EPD_BUSY: DS1.9 (BUSY), U6.7 (GPI35/ADC1_CH7/RTC_GPIO5)
ESP_EN: C21.2, J4.25, Q6.6 (C1), R26.2, SW1.2, U6.3 (EN)
EXT_GPIO0: J4.10, U5.17 (P5)
EXT_GPIO1: J4.11, U5.19 (P6)
EXT_GPIO2: J4.12, U5.20 (P7)
GDR: DS1.2 (GDR), Q2.1 (G), R5.1
GND: BATT1.2 (-), C1.2, C2.1, C3.2, C4.2, C5.2, C6.2, C8.2, C9.1, C10.1, C11.1, C12.2, C13.2, C14.2, C15.2, C16.2, C17.2, C18.1, C19.1, C20.1, C21.1, C22.1, C23.2, C24.1, D2.1 (K), DS1.8 (BS1), DS1.17 (VSS), J1.5 (GND), J1.6 (Shield), J3.13, J3.14, J4.1, J4.15, J4.20, J4.22, J4.26, MICRO_SD1.6 (VSS), MICRO_SD1.10 (SHIELD), Q8.2 (S), R2.2, R3.2, R5.2, R6.2, R10.1, R29.2, SW1.1, TH1.2, U1.2 (GND), U2.5 (GND), U3.2 (GND), U4.2 (GND), U4.25 (PAD), U5.6 (A0), U5.7 (A1), U5.9 (A2), U5.15 (VSS), U6.1 (GND), U6.15 (GND), U6.38 (GND), U6.39 (THERMAL_PAD)
GPIO_0: Q6.3 (C2), R24.1, U6.25 (GPIO0/ADC2_CH1/TOUCH1/RTC_GPIO11/CLK_OU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)
GPIO_2: Q7.6 (C1), R25.1, U6.24 (GPIO2/ADC2_CH2/TOUCH2/RTC_GPIO12/HSPIWP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)
I2C_SCL: J4.14, R19.1, U5.2 (SCL), U6.28 (GPIO17/HS1_DATA5/U2TXD/EMAC_CLK_OUT_180)
I2C_SDA: J4.13, R20.1, U5.4 (SDA), U6.27 (GPIO16/HS1_DATA4/U2RXD/EMAC_CLK_OUT)
JTAG_TCK: J4.19, U6.16 (GPIO13/ADC2_CH4/TOUCH4/RTC_GPIO14/MTCK/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)
JTAG_TDI: J4.23, U6.14 (GPIO12/ADC2_CH5/TOUCH5/RTC_GPIO15/MTDI/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)
JTAG_TDO: J4.21, U6.23 (GPIO15/ADC2_CH3/TOUCH3/MTDO/HSPICS0/RTC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)
JTAG_TMS: J4.17, U6.13 (GPIO14/ADC2_CH6/TOUCH6/RTC_GPIO16/MTMS/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)
unnamed: BZ1.2 (+), Q8.3 (D), R27.2
unnamed: C1.1, DS1.4 (VGL)
unnamed: C3.1, DS1.5 (VGH)
unnamed: C5.1, D4.1 (K), Q1.2 (S), R1.2, U1.1 (VIN)
unnamed: C7.1, D3.2 (A), L1.2, Q2.3 (D)
unnamed: C7.2, D1.1 (K), D2.2 (A)
unnamed: C12.1, DS1.18 (VDD)
unnamed: C13.1, DS1.19 (VPP)
unnamed: C14.1, DS1.20 (VSH)
unnamed: C15.1, DS1.22 (VSL)
unnamed: C16.1, DS1.24 (VCOM)
unnamed: C17.1, JP1.2 (B), U4.5 (VIO), U4.6 (VDD), U4.7 (REGIN)
unnamed: D5.3 (A), J2.1, J2.2
unnamed: D5.4 (GK), J2.7, J2.8
unnamed: J2.5, J2.6, S2.1
unnamed: J2.9, J2.10, S1.1
unnamed: J2.13, J2.14
unnamed: J3.7, J3.8, R24.2
unnamed: MICRO_SD1.1 (DAT2/RES), R18.2
unnamed: MICRO_SD1.8 (DAT1/RES), R13.2
unnamed: Q3.1 (G), R8.1
unnamed: Q4.1 (G), R12.1
unnamed: Q4.3 (D), R9.2
unnamed: Q5.1 (G), R22.1
unnamed: Q8.1 (G), R28.1, R29.1
unnamed: R1.1, U1.3 (EN)
unnamed: R2.1, U2.6 (ISET)
unnamed: TH1.1, U2.1 (TS)
PREVGH: C10.2, D3.1 (K), DS1.21 (PREVGH)
PREVGL: C2.2, D1.2 (A), DS1.23 (PREVGL)
RESE: DS1.3 (RESE), Q2.2 (S), R6.1
RTS: J4.4, Q6.1 (E1), Q6.5 (B2), Q7.2 (B1), U4.19 (RTS)
SPI_MISO: J4.9, MICRO_SD1.7 (DAT0/DO), R14.2, U6.31 (GPIO19/VSPIQ/U0CTS/EMAC_TXD0)
SPI_MOSI: DS1.14 (SDIO), J4.7, MICRO_SD1.3 (CMD/DI), R16.2, U6.37 (GPIO23/VSPID/HS1_STROBE)
SPI_SCLK: DS1.13 (SCLK), J4.8, MICRO_SD1.5 (CLK/SCLK), R15.2, U6.30 (GPIO18/VSPICLK/HS1_DATA7)
UART_RXD0: J4.6, U4.21 (TXD), U6.34 (GPIO3/U0RXD/CLK_OUT2)
UART_TXD0: J4.5, U4.20 (RXD), U6.35 (GPIO1/U0TXD/CLK_OUT3/EMAC_RXD2)
USB_N: U3.6 (IO1), U4.4 (D-)
USB_P: U3.4 (IO2), U4.3 (D+)
VBUS: C6.1, D4.2 (A), J1.1 (VBUS), Q1.1 (G), R3.1, U2.4 (VIN), U3.5 (VBUS), U4.8 (VBUS)
V_EPD: C9.2, C11.2, DS1.15 (VDDIO), DS1.16 (VCI), L1.1, Q3.3 (D), R4.2
V_SD: C18.2, MICRO_SD1.4 (VDD), Q5.3 (D), R13.1, R14.1, R15.1, R16.1, R17.1, R18.1
~BATT_EN: R11.1, R12.2, U5.11 (P1)
~CHG: U2.3 (~CHG), U6.4 (GPI36/SENSOR_VP/ADC_H/ADC1_CH0/RTC_GPIO0)
~EPD_CS: DS1.12 (~CS), R4.1, U6.36 (GPIO22/VSPIWP/U0RTS/EMAC_TXD1)
~EPD_DC: DS1.11 (~D/C), U6.11 (GPIO26/DAC_2/ADC2_CH9/RTC_GPIO7/EMAC_RX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)
~EPD_EN: R7.1, R8.2, U5.10 (P0)
~EPD_RES: DS1.10 (~RES), U5.14 (P3)
~FPC_LED_B: D5.2 (BK), J2.11, J2.12, J3.11, J3.12, R25.2
~FPC_LED_R: D5.1 (RK), J2.3, J2.4, J3.3, J3.4, R23.2
~LED_R: R23.1, U6.29 (GPIO5/VSPICS0/HS1_DATA6/EMAC_RX_CLK)
~PCF_INT: U5.1 (~INT~), U6.5 (GPI39/SENSOR_VN/ADC1_CH3/ADC_H/RTC_GPIO3)
~SD_CD: MICRO_SD1.9 (~CD), U5.16 (P4)
~SD_CS: MICRO_SD1.2 (CD/DAT3/~CS), R17.2, U6.33 (GPIO21/VSPIHD/EMAC_TX_EN)
~SD_EN: R21.1, R22.2, U5.12 (P2)

Notes on the sheet:
Note: LED and capacitive buttons are on different PCB connected using FPC
Battery Sensing
IO Expansion
LED
3.246V -> 4.2V
BUTTON
BUZZER
Power Supply and Battery Charging
FPC
Note: Cut JP1 for lower power consumption and then program through headers
USB to UART Interface
Charging current of 450mA Ichg = Kiset/Riset Kiset = 540 A ohm
ESP32-WROOM
DTR RTS IO0 IO2 EN 1 1 1 1 1 0 0 1 1 1 1 0 1 1 0 0 1 0 0 1
Auto Program
Integrated Flash
SD Card
E-Paper
Current Sense
External Header
JTAG DEBUG
NOTES:
- Add provison in next rev to eliminate GPIO expander
+ Check e-paper display inductor requirement + Battery charger resistor value + Battery Sense Resistors + JST PH 2 pin for battery connector ? Reverse Polarity on the input - check in spice what would happen for existing circuit + ESD Protection + Add Auto-program circuit + Check if GPIO2 is requir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
TO-DO
References
SD Card: https://www.alliedelec.com/m/d/04db416b291011446889dbd6129e2644.pdf LED: https://hackaday.com/2017/01/20/cheating-at-5v-ws2812-control-to-use-a-3-3v-data-line/ JTAG: http://www.keil.com/support/man/docs/ulink2/ulink2_hw_connectors.htm

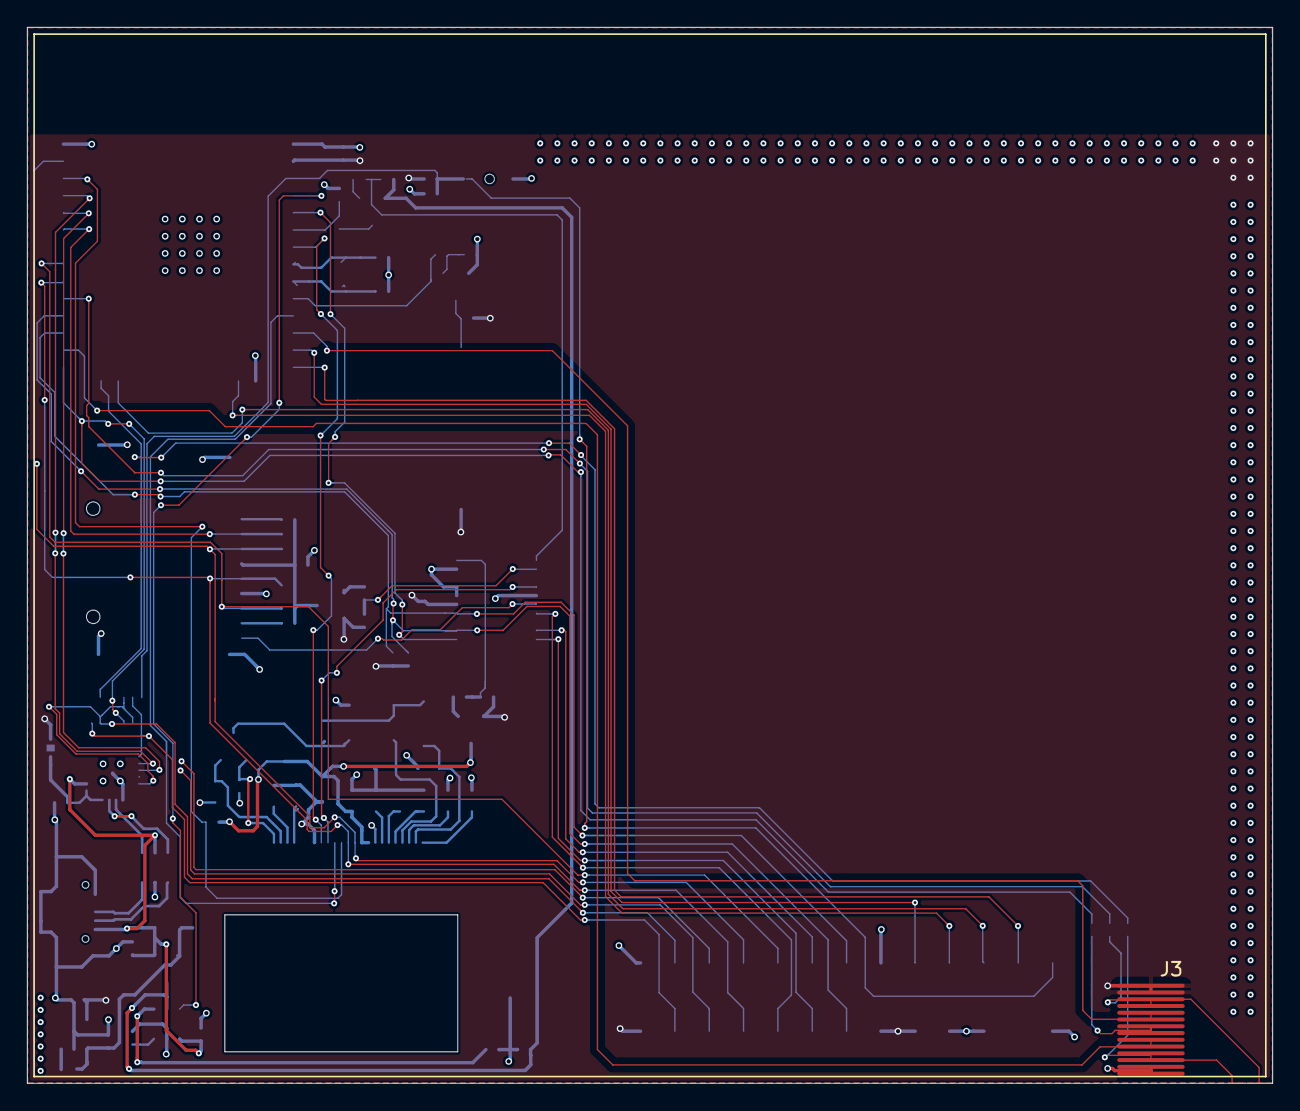
[picture p12: board paperd.ink_main_pcb.kicad_pcb from above]

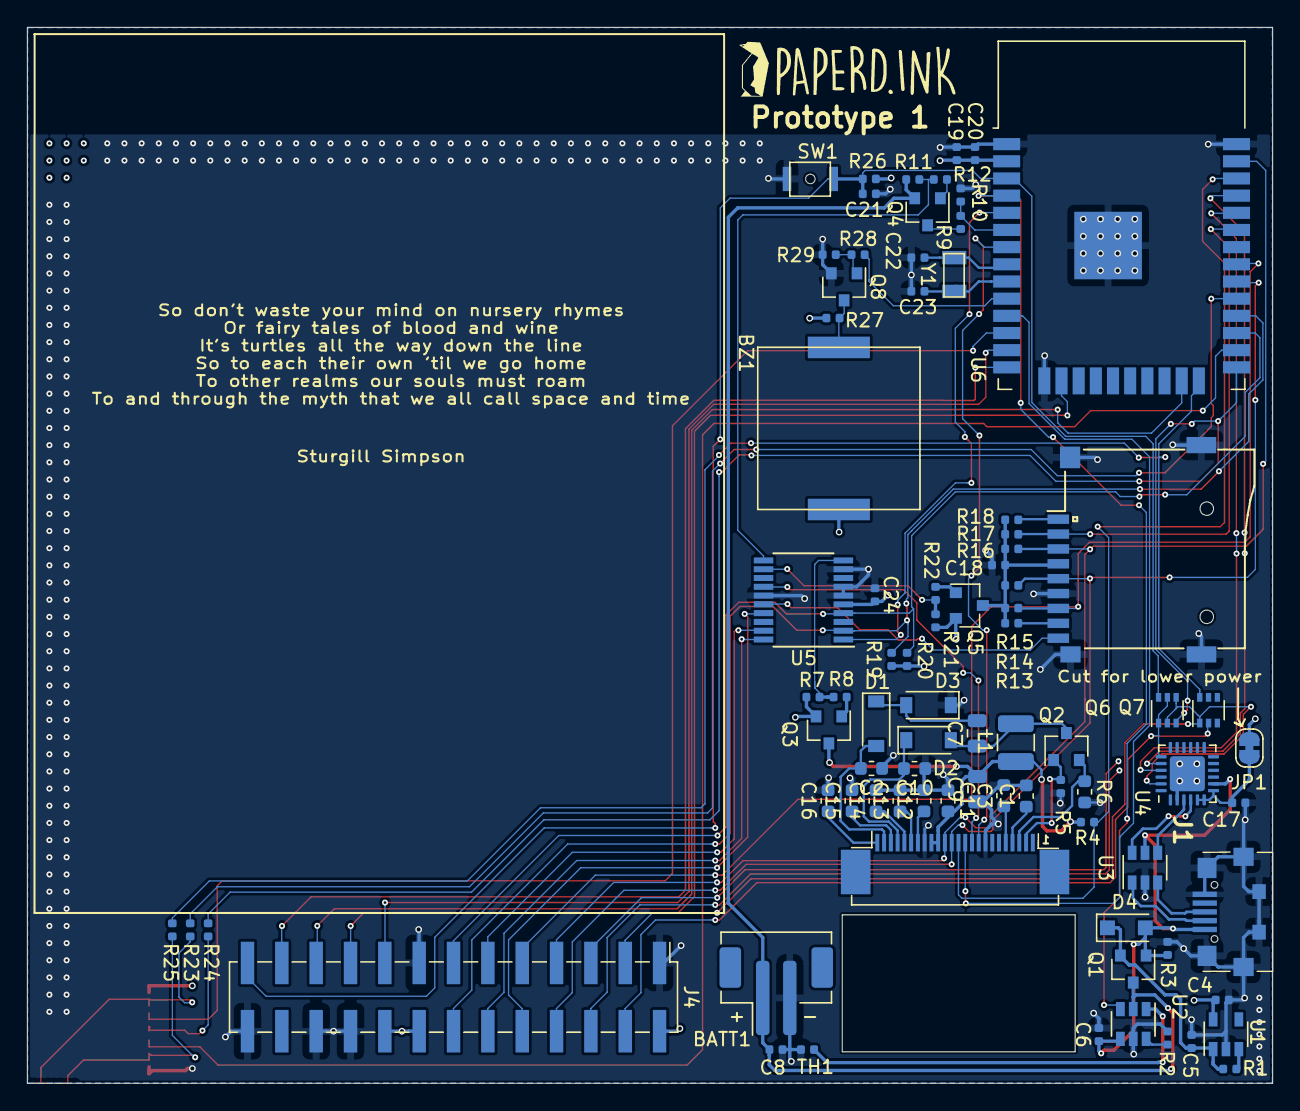
[picture p13: board paperd.ink_main_pcb.kicad_pcb from below]

Board: 4 copper layers, 92.1 x 78.1 mm, 83 parts (81 on the bottom side), 76 nets.
