paperdink/paperd.ink_hw/(commit log)

2022-04-13 Added hardware files
    [Deep_Sleep_CC.xlsx, ESP32_Pinout.xlsx, paperd.ink.dxf, paperd.ink.kicad_pcb, paperd.ink.kicad_sch, paperd.ink_BOM.xlsx, paperd.ink_V1.kicad_sch, paperd.ink_V1.sch]
2022-07-19 Added paperd.ink rev4
    [paperd_ink_rev3_BOM.csv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]
2022-07-19 Added BOM
    [paperd_ink_rev3_BOM.csv, paperd_ink_rev4.csv, paperd_ink_rev4.kicad_sch, paperd_ink_rev4_BOM.xlsx]
